cclienti/tig-welder/boards/small-power/small-power.kicad_pcb

## KiCad design boards/small-power/small-power.kicad_pcb (2023-11-25)

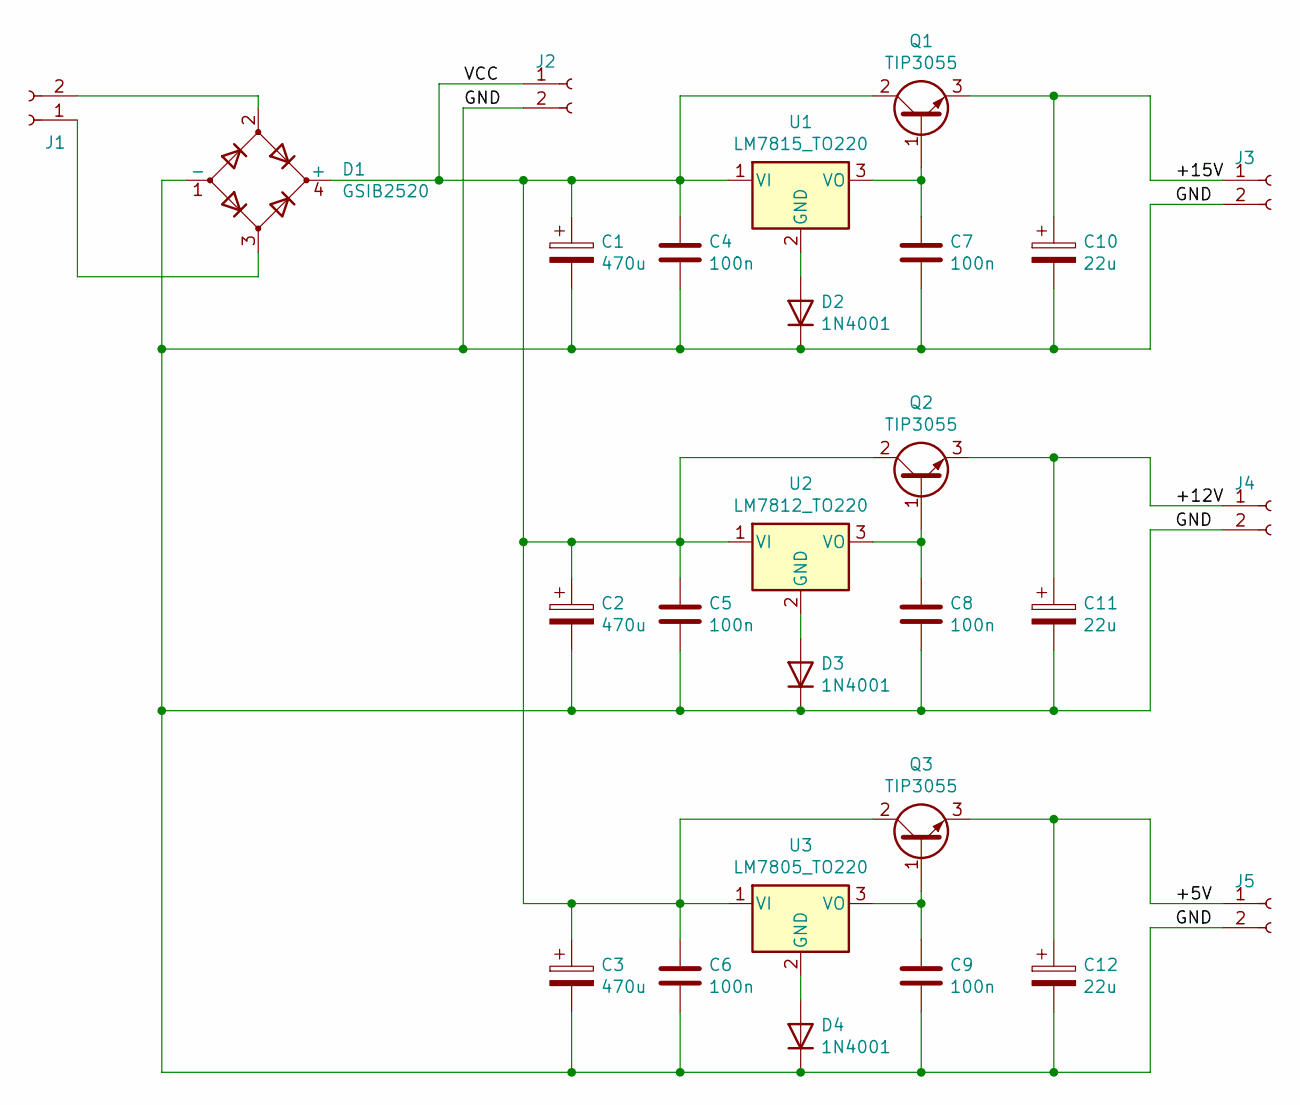
[picture p1: schematic small-power.kicad_sch, Small Power Board]

Parts:
C1, C2, C3: 470u; CP_Radial_D13.0mm_P5.00mm
C4, C5, C6, C7, C8, C9: 100n; C_Rect_L4.6mm_W2.0mm_P2.50mm_MKS02_FKP02
C10, C11, C12: 22u; CP_Radial_D5.0mm_P2.50mm
D1: GSIB2520; Diode_Bridge_32.0x5.6x17.0mm_P10.0mm_P7.5mm
D2, D3, D4: 1N4001; D_DO-41_SOD81_P10.16mm_Horizontal
J1, J2, J3, J4, J5: Conn_01x02_Female; PhoenixContact_MSTBVA_2,5_2-G-5,08_1x02_P5.08mm_Vertical
Q1, Q2, Q3: TIP3055; TO-218-3_Vertical
U1: LM7815_TO220; TO-220-3_Vertical
U2: LM7812_TO220; TO-220-3_Vertical
U3: LM7805_TO220; TO-220-3_Vertical

Connections:
/+5V: C12.1, J5.1, Q3.3 (E)
/+12V: C11.1, J4.1, Q2.3 (E)
/+15V: C10.1, J3.1, Q1.3 (E)
/GND: C1.2, C2.2, C3.2, C4.2, C5.2, C6.2, C7.2, C8.2, C9.2, C10.2, C11.2, C12.2, D1.1 (-), D2.1 (K), D3.1 (K), D4.1 (K), J2.2, J3.2, J4.2, J5.2
/VCC: C1.1, C2.1, C3.1, C4.1, C5.1, C6.1, D1.4 (+), J2.1, Q1.2 (C), Q2.2 (C), Q3.2 (C), U1.1 (VI), U2.1 (VI), U3.1 (VI)
unnamed: C7.1, Q1.1 (B), U1.3 (VO)
unnamed: C8.1, Q2.1 (B), U2.3 (VO)
unnamed: C9.1, Q3.1 (B), U3.3 (VO)
unnamed: D1.2, J1.2
unnamed: D1.3, J1.1
unnamed: D2.2 (A), U1.2 (GND)
unnamed: D3.2 (A), U2.2 (GND)
unnamed: D4.2 (A), U3.2 (GND)

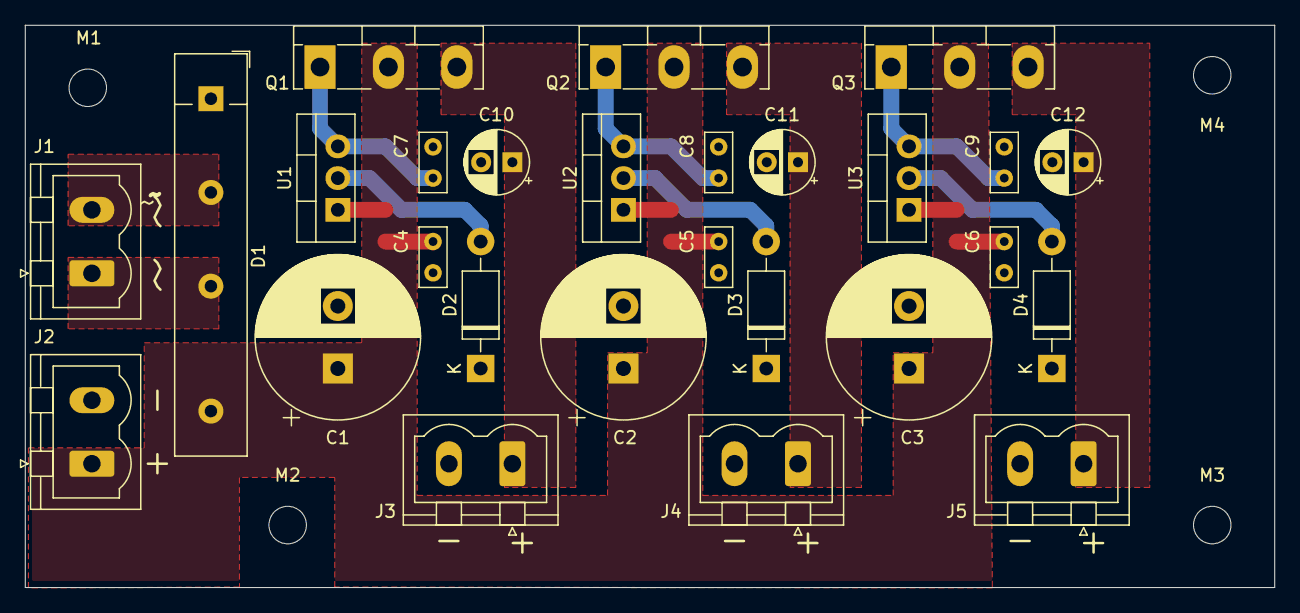
[picture p2: board small-power.kicad_pcb from above]

Board: 2 copper layers, 100.0 x 45.0 mm, 31 parts (0 on the bottom side), 13 nets.

Other parts of the board:
M1, M2, M3, M4: MountingHole_3mm
