cclienti/tig-welder/boards/slow-switching-outputs/slow-switching-outputs.kicad_pcb

## KiCad design boards/slow-switching-outputs/slow-switching-outputs.kicad_pcb (2023-11-25)

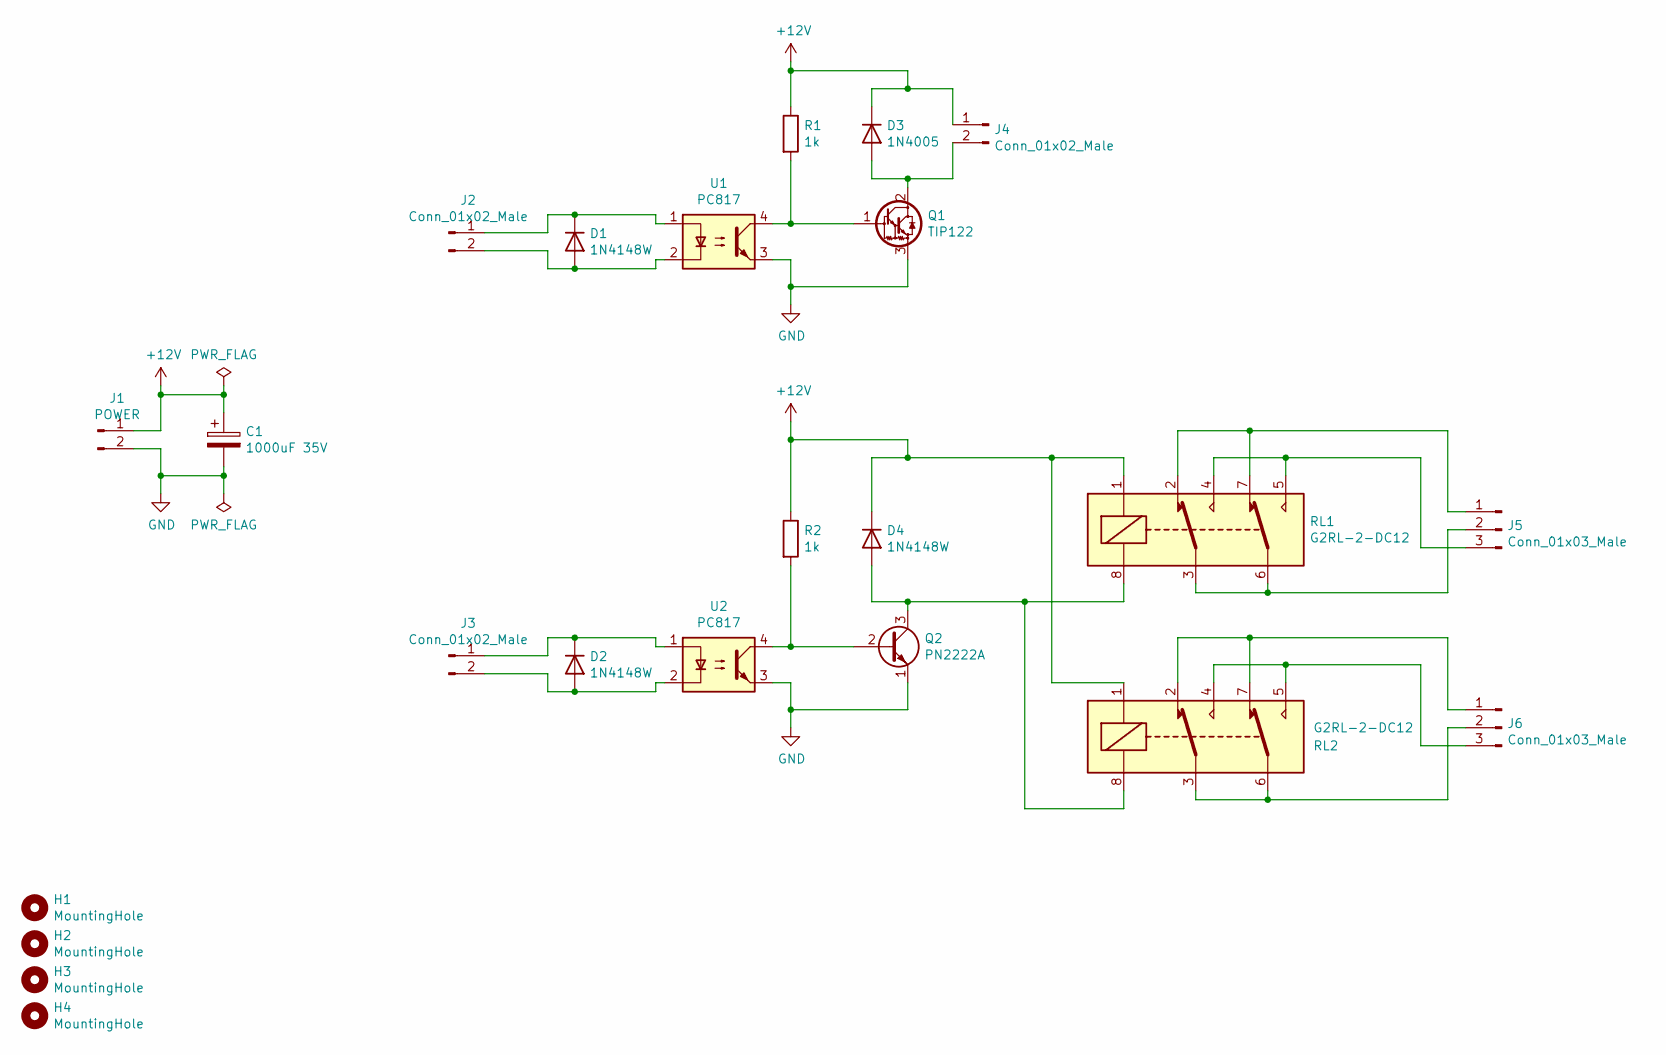
[picture p3: schematic slow-switching-outputs.kicad_sch, Slow Switching Outputs]

Parts:
C1: 1000uF 35V; CP_Radial_D16.0mm_P7.50mm
D1, D2, D4: 1N4148W; D_SOD-123
D3: 1N4005; D_SMB_Handsoldering
H1, H2, H3, H4: MountingHole; MountingHole_3.2mm_M3_Pad
J1: POWER; PhoenixContact_MSTBVA_2,5_2-G-5,08_1x02_P5.08mm_Vertical
J2, J3: Conn_01x02_Male; PinHeader_1x02_P2.54mm_Vertical
J4: Conn_01x02_Male; PhoenixContact_MSTBVA_2,5_2-G-5,08_1x02_P5.08mm_Vertical
J5, J6: Conn_01x03_Male; PhoenixContact_MSTBVA_2,5_3-G-5,08_1x03_P5.08mm_Vertical
Q1: TIP122; TO-220-3_Vertical
Q2: PN2222A; TO-18-3
R1, R2: 1k; R_1206_3216Metric_Pad1.30x1.75mm_HandSolder
RL1, RL2: G2RL-2-DC12; Relay_DPDT_Omron_G2RL
U1, U2: PC817; DIP-4_W7.62mm

Connections:
+12V: C1.1, D3.1 (K), D4.1 (K), J1.1, J4.1, R1.1, R2.1, RL1.1, RL2.1
GND: C1.2, J1.2, Q1.3 (E), Q2.1 (E), U1.3, U2.3
unnamed: D1.1 (K), J2.1, U1.1
unnamed: D1.2 (A), J2.2, U1.2
unnamed: D2.1 (K), J3.1, U2.1
unnamed: D2.2 (A), J3.2, U2.2
unnamed: D3.2 (A), J4.2, Q1.2 (C)
unnamed: D4.2 (A), Q2.3 (C), RL1.8, RL2.8
unnamed: J5.1, RL1.2, RL1.7
unnamed: J5.2, RL1.3, RL1.6
unnamed: J5.3, RL1.4, RL1.5
unnamed: J6.1, RL2.2, RL2.7
unnamed: J6.2, RL2.3, RL2.6
unnamed: J6.3, RL2.4, RL2.5
unnamed: Q1.1 (B), R1.2, U1.4
unnamed: Q2.2 (B), R2.2, U2.4

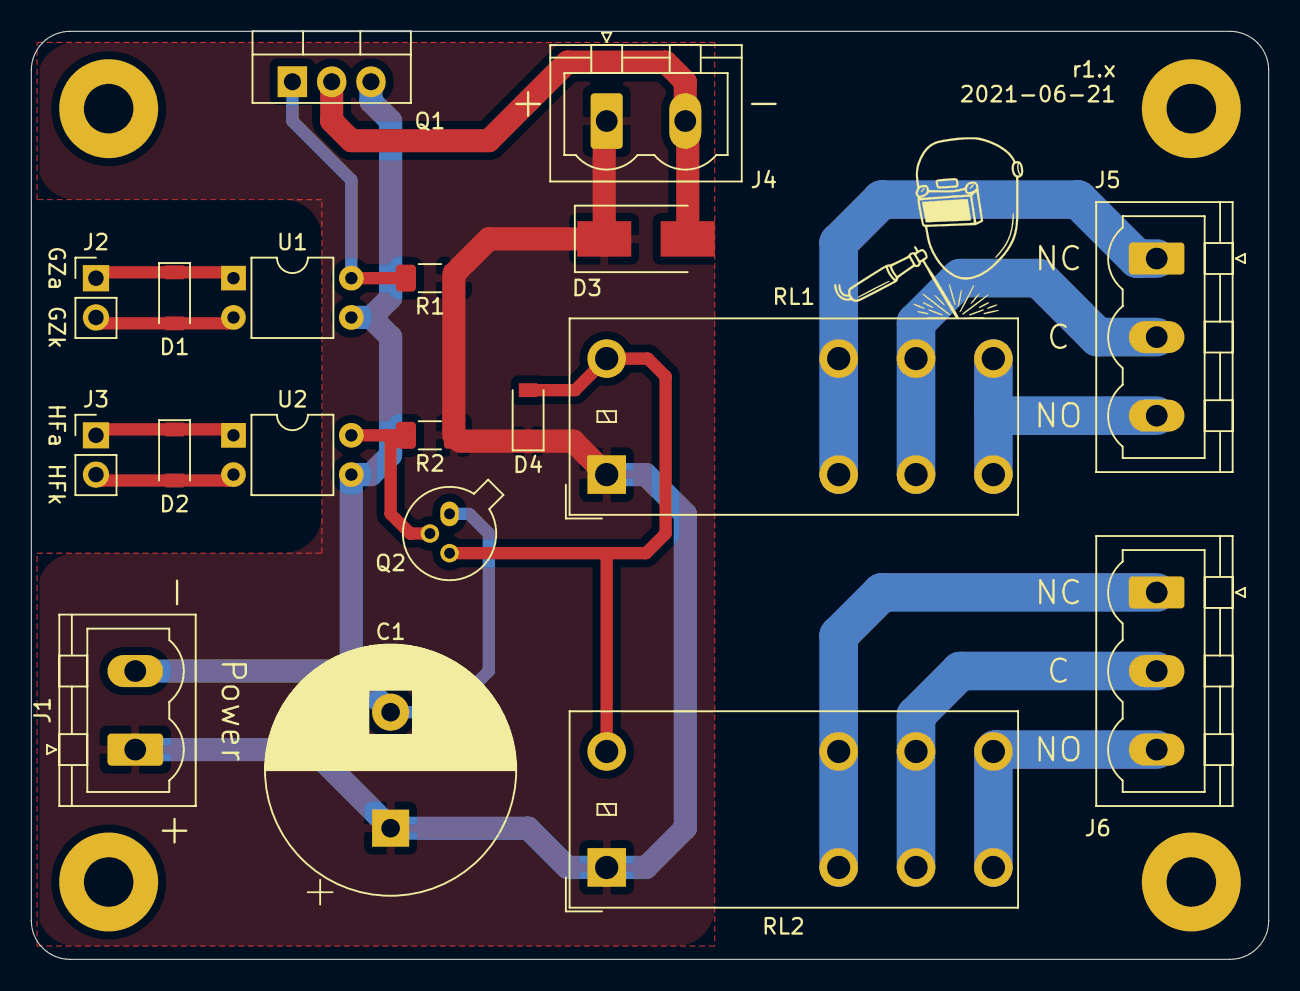
[picture p4: board slow-switching-outputs.kicad_pcb from above]

Board: 2 copper layers, 80.0 x 60.0 mm, 23 parts (0 on the bottom side), 16 nets.
