cclienti/tig-welder/boards/power-driver/power-driver.kicad_pcb

## KiCad design boards/power-driver/power-driver.kicad_pcb (2023-11-25)

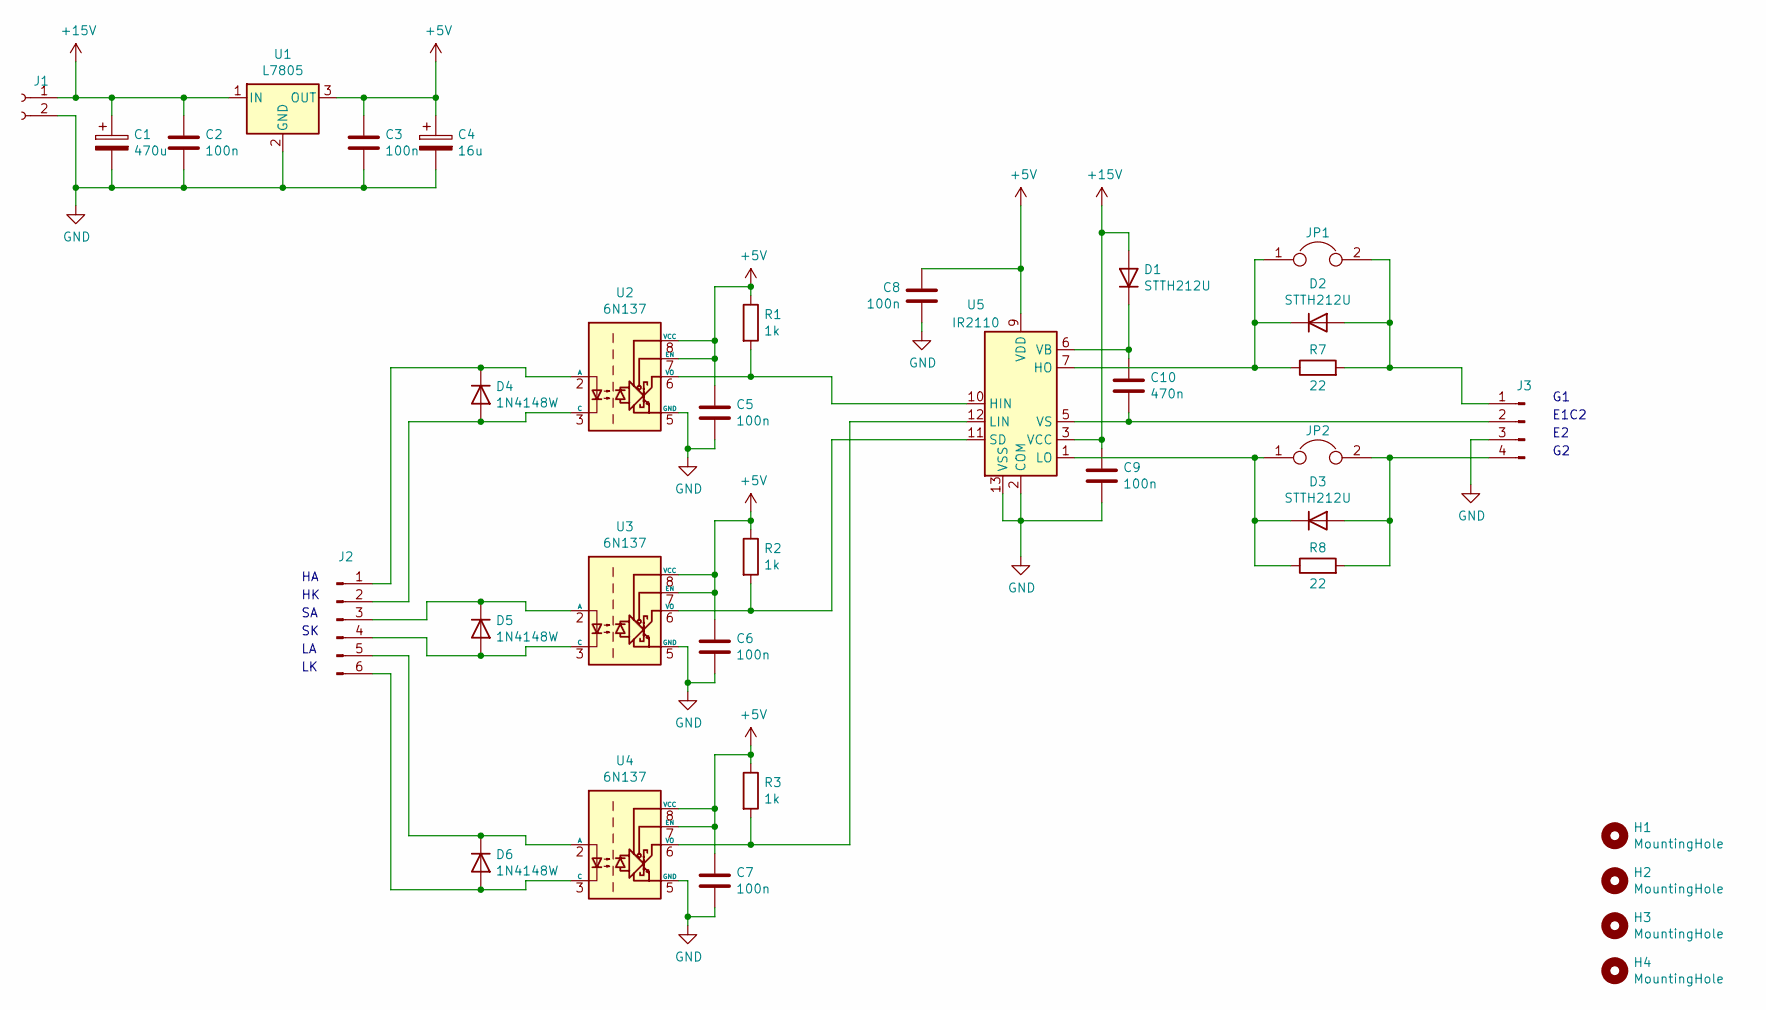
[picture p5: schematic power-driver.kicad_sch, Half Bridge Driver]

Parts:
C1: 470u; CP_Elec_6.3x7.7
C2, C3, C5, C6, C7, C8, C9: 100n; C_1206_3216Metric_Pad1.33x1.80mm_HandSolder
C4: 16u; CP_Elec_5x5.3
C10: 470n; C_Rect_L13.0mm_W6.0mm_P10.00mm_FKS3_FKP3_MKS4
D1, D2, D3: STTH212U; D_SMB
D4, D5, D6: 1N4148W; D_SOD-123
H1, H2, H3, H4: MountingHole; MountingHole_3.2mm_M3_Pad
J1: Conn_01x02_Female; PhoenixContact_MSTBVA_2,5_2-G-5,08_1x02_P5.08mm_Vertical
J2: Conn_01x06_Male; PinHeader_1x06_P2.54mm_Vertical
J3: Conn_01x04_Male; PinHeader_1x04_P2.54mm_Vertical
JP1, JP2: Jumper; PinHeader_1x02_P2.54mm_Vertical
R1, R2, R3: 1k; R_1206_3216Metric_Pad1.30x1.75mm_HandSolder
R7, R8: 22; R_1206_3216Metric_Pad1.30x1.75mm_HandSolder
U1: L7805; TO-220-3_Horizontal_TabDown
U2, U3, U4: 6N137; DIP-8_W7.62mm
U5: IR2110; DIP-14_W7.62mm

Connections:
+5V: C3.1, C4.1, C5.1, C6.1, C7.1, C8.2, R1.1, R2.1, R3.1, U1.3 (OUT), U2.7 (EN), U2.8 (VCC), U3.7 (EN), U3.8 (VCC), U4.7 (EN), U4.8 (VCC), U5.9 (VDD)
+15V: C1.1, C2.1, C9.1, D1.2 (A), J1.1, U1.1 (IN), U5.3 (VCC)
GND: C1.2, C2.2, C3.2, C4.2, C5.2, C6.2, C7.2, C8.1, C9.2, J1.2, J3.3, U1.2 (GND), U2.5 (GND), U3.5 (GND), U4.5 (GND), U5.2 (COM), U5.13 (VSS)
unnamed: C10.1, D1.1 (K), U5.6 (VB)
unnamed: C10.2, J3.2, U5.5 (VS)
unnamed: D2.1 (K), JP1.1, R7.1, U5.7 (HO)
unnamed: D2.2 (A), J3.1, JP1.2, R7.2
unnamed: D3.1 (K), JP2.1, R8.1, U5.1 (LO)
unnamed: D3.2 (A), J3.4, JP2.2, R8.2
unnamed: D4.1 (K), J2.1, U2.2 (A)
unnamed: D4.2 (A), J2.2, U2.3 (C)
unnamed: D5.1 (K), J2.3, U3.2 (A)
unnamed: D5.2 (A), J2.4, U3.3 (C)
unnamed: D6.1 (K), J2.5, U4.2 (A)
unnamed: D6.2 (A), J2.6, U4.3 (C)
unnamed: R1.2, U2.6 (VO), U5.10 (HIN)
unnamed: R2.2, U3.6 (VO), U5.11 (SD)
unnamed: R3.2, U4.6 (VO), U5.12 (LIN)

Notes on the sheet:
E1C2

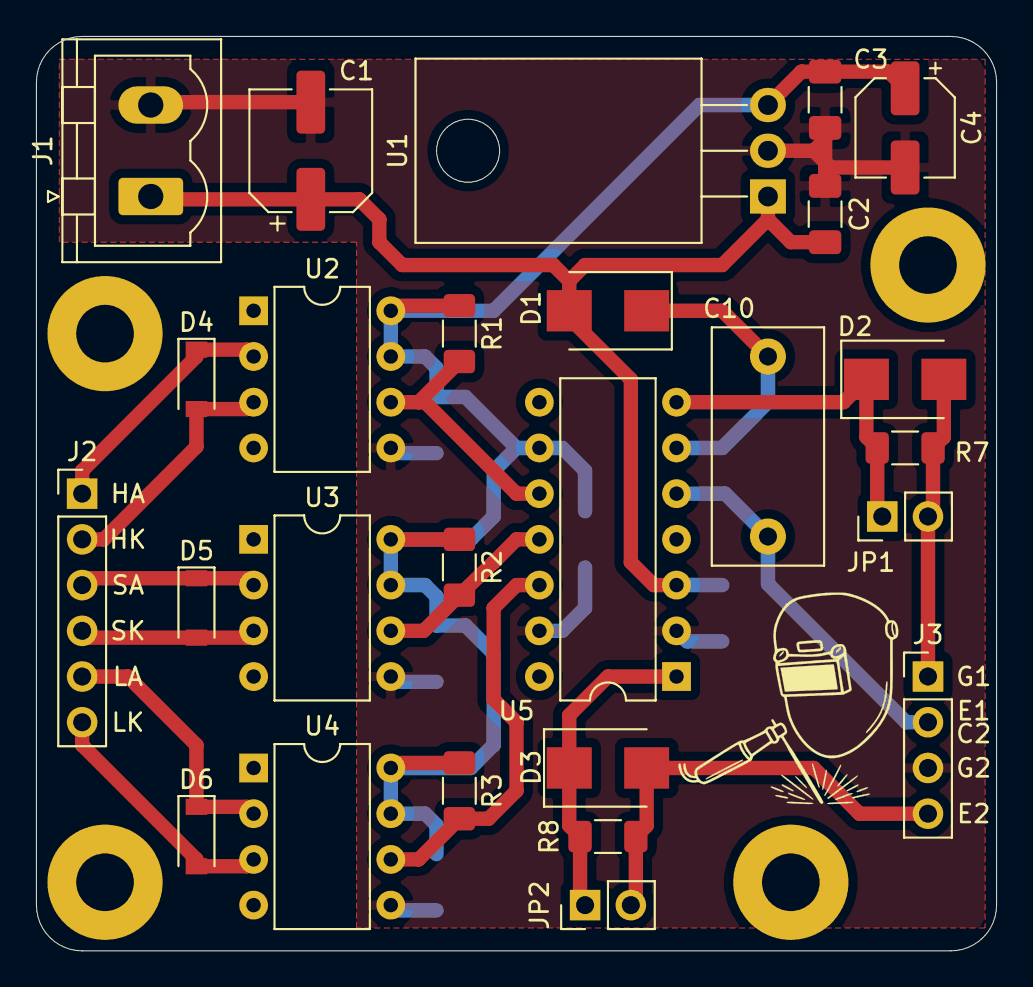
[picture p6: board power-driver.kicad_pcb from above]

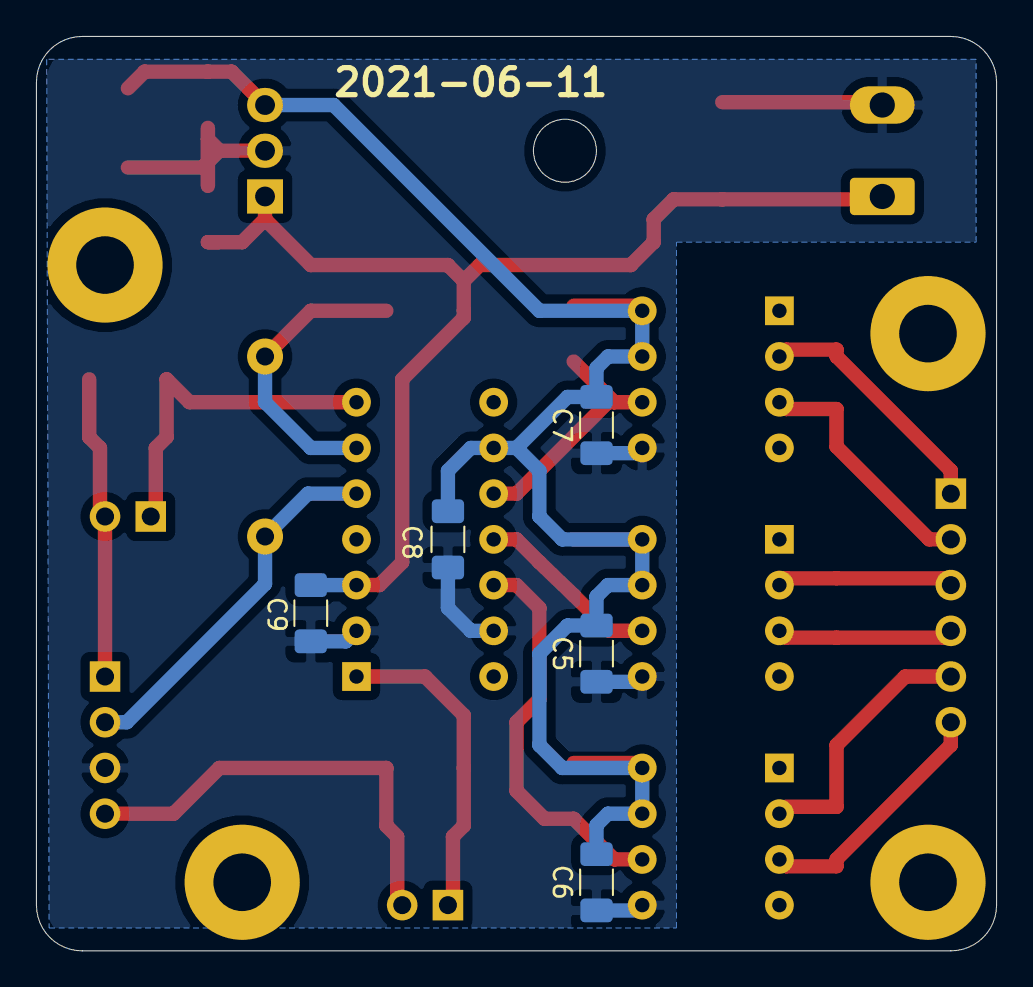
[picture p7: board power-driver.kicad_pcb from below]

Board: 2 copper layers, 53.3 x 50.8 mm, 35 parts (5 on the bottom side), 18 nets.
