cclienti/tig-welder/boards/half-bridge-mod/half-bridge-mod.kicad_pcb

## KiCad design boards/half-bridge-mod/half-bridge-mod.kicad_pcb (2023-11-25)

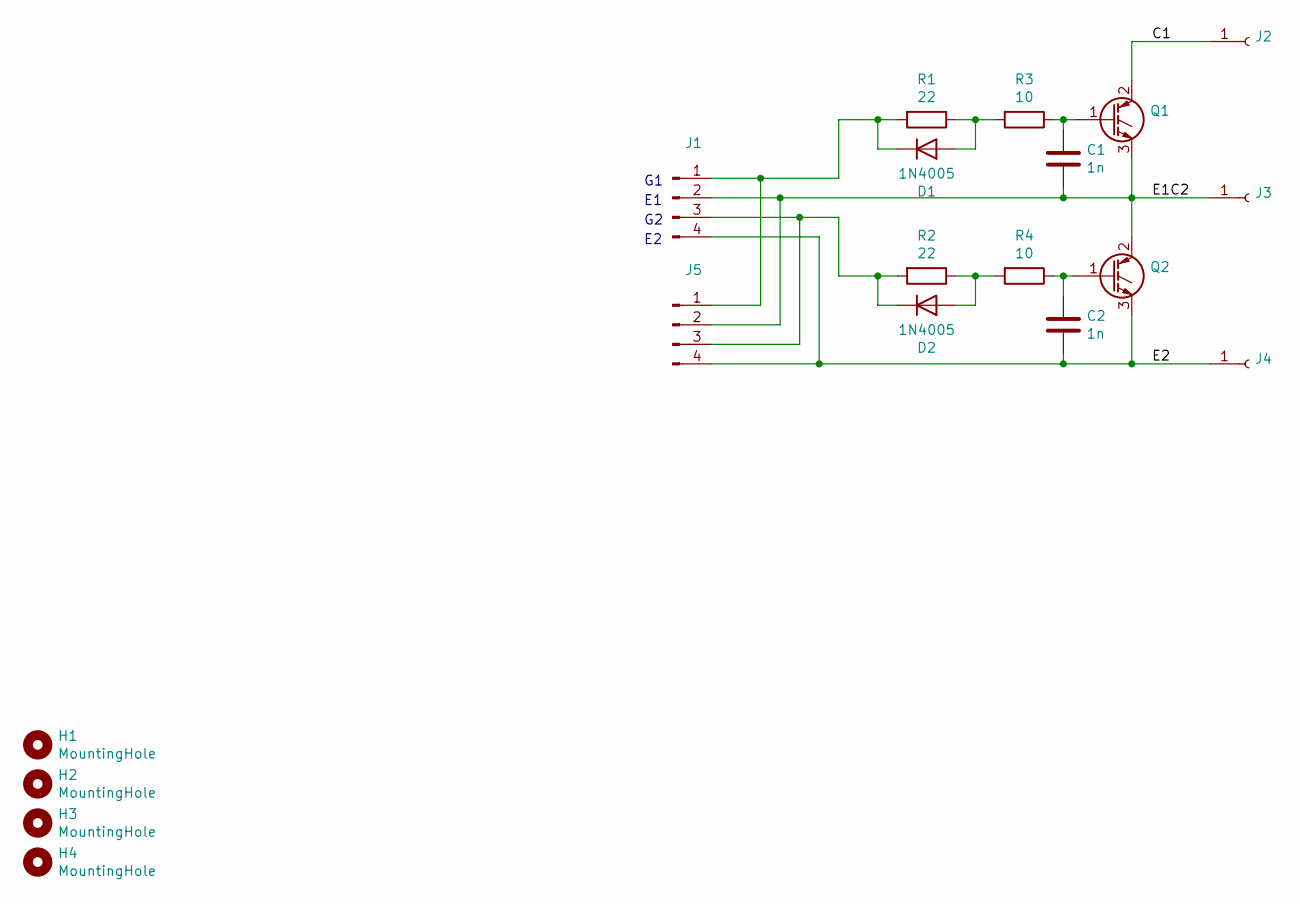
[picture p8: schematic half-bridge-mod.kicad_sch, Modular Half-Bridge]

Parts:
C1, C2: 1n; C_1206_3216Metric
D1, D2: 1N4005; D_SMA
H1, H2, H3, H4: MountingHole; MountingHole_2.2mm_M2
J1, J5: Conn_01x04_Male; PinHeader_1x04_P2.54mm_Vertical
J2, J3, J4: Conn_01x01_Female; Terminal_Block_Welder_no_hole
Q1, Q2: Q_NIGBT_GCE; TO-247-3_Horizontal_TabUp
R1, R2: 22; R_1206_3216Metric
R3, R4: 10; R_1206_3216Metric

Connections:
/C1: J2.1, Q1.2 (C)
/E1C2: C1.2, J1.2, J3.1, J5.2, Q1.3 (E), Q2.2 (C)
/E2: C2.2, J1.4, J4.1, J5.4, Q2.3 (E)
unnamed: C1.1, Q1.1 (G), R3.1
unnamed: C2.1, Q2.1 (G), R4.1
unnamed: D1.1 (K), J1.1, J5.1, R1.2
unnamed: D1.2 (A), R1.1, R3.2
unnamed: D2.1 (K), J1.3, J5.3, R2.2
unnamed: D2.2 (A), R2.1, R4.2

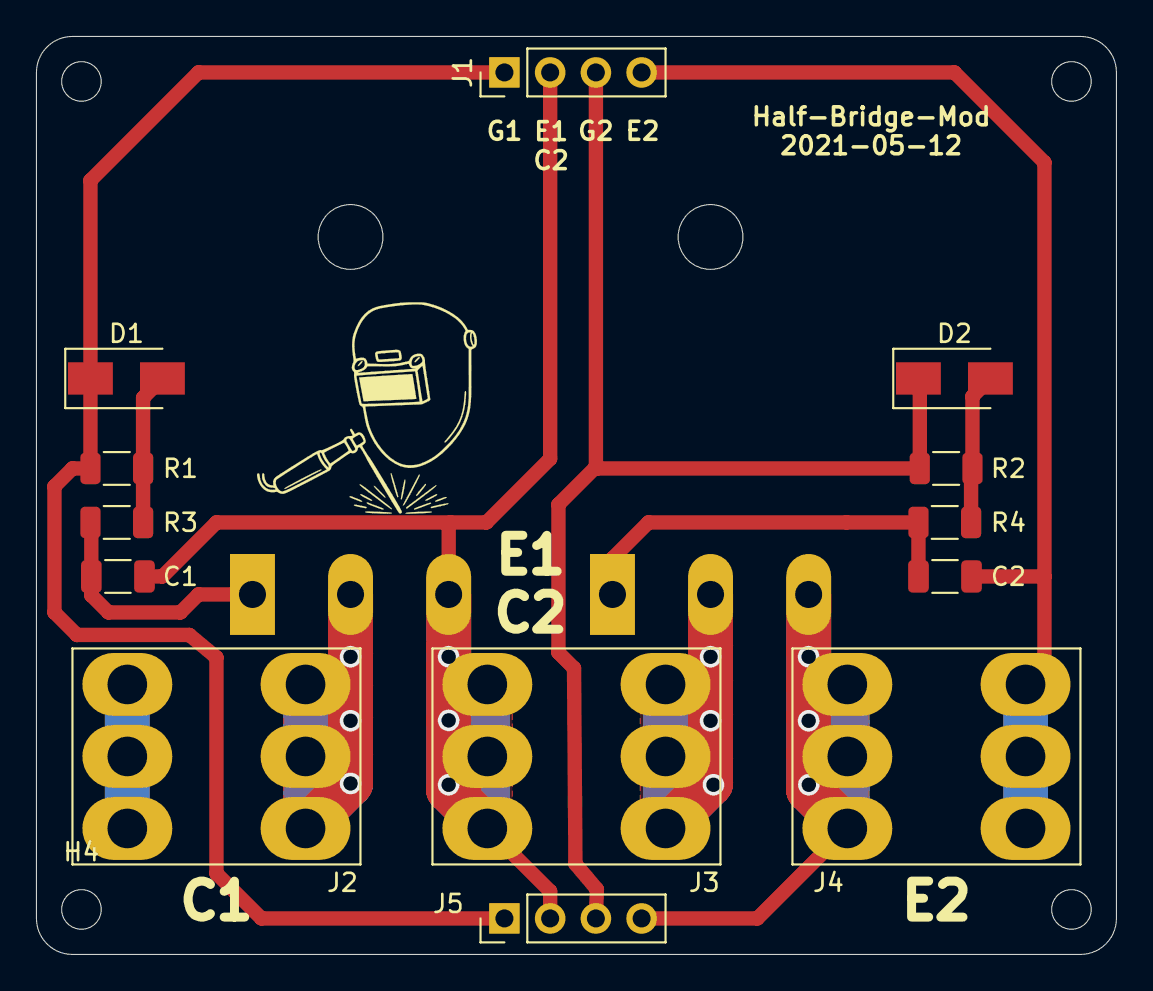
[picture p9: board half-bridge-mod.kicad_pcb from above]

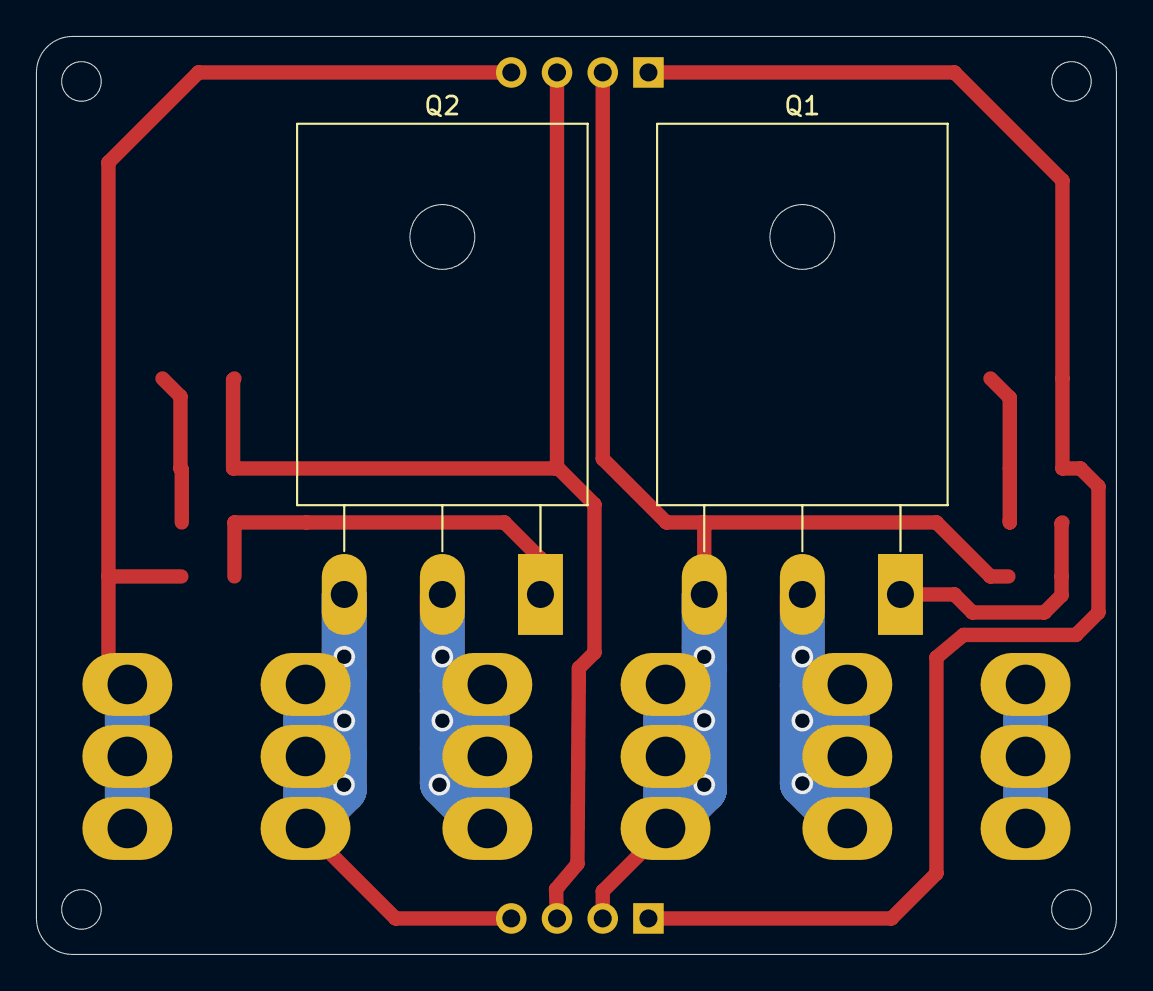
[picture p10: board half-bridge-mod.kicad_pcb from below]

Board: 2 copper layers, 60.0 x 51.0 mm, 19 parts (2 on the bottom side), 9 nets.
