cclienti/tig-welder/boards/dspic-controller/dspic-controller.kicad_pcb

## KiCad design boards/dspic-controller/dspic-controller.kicad_pcb (2023-11-25)

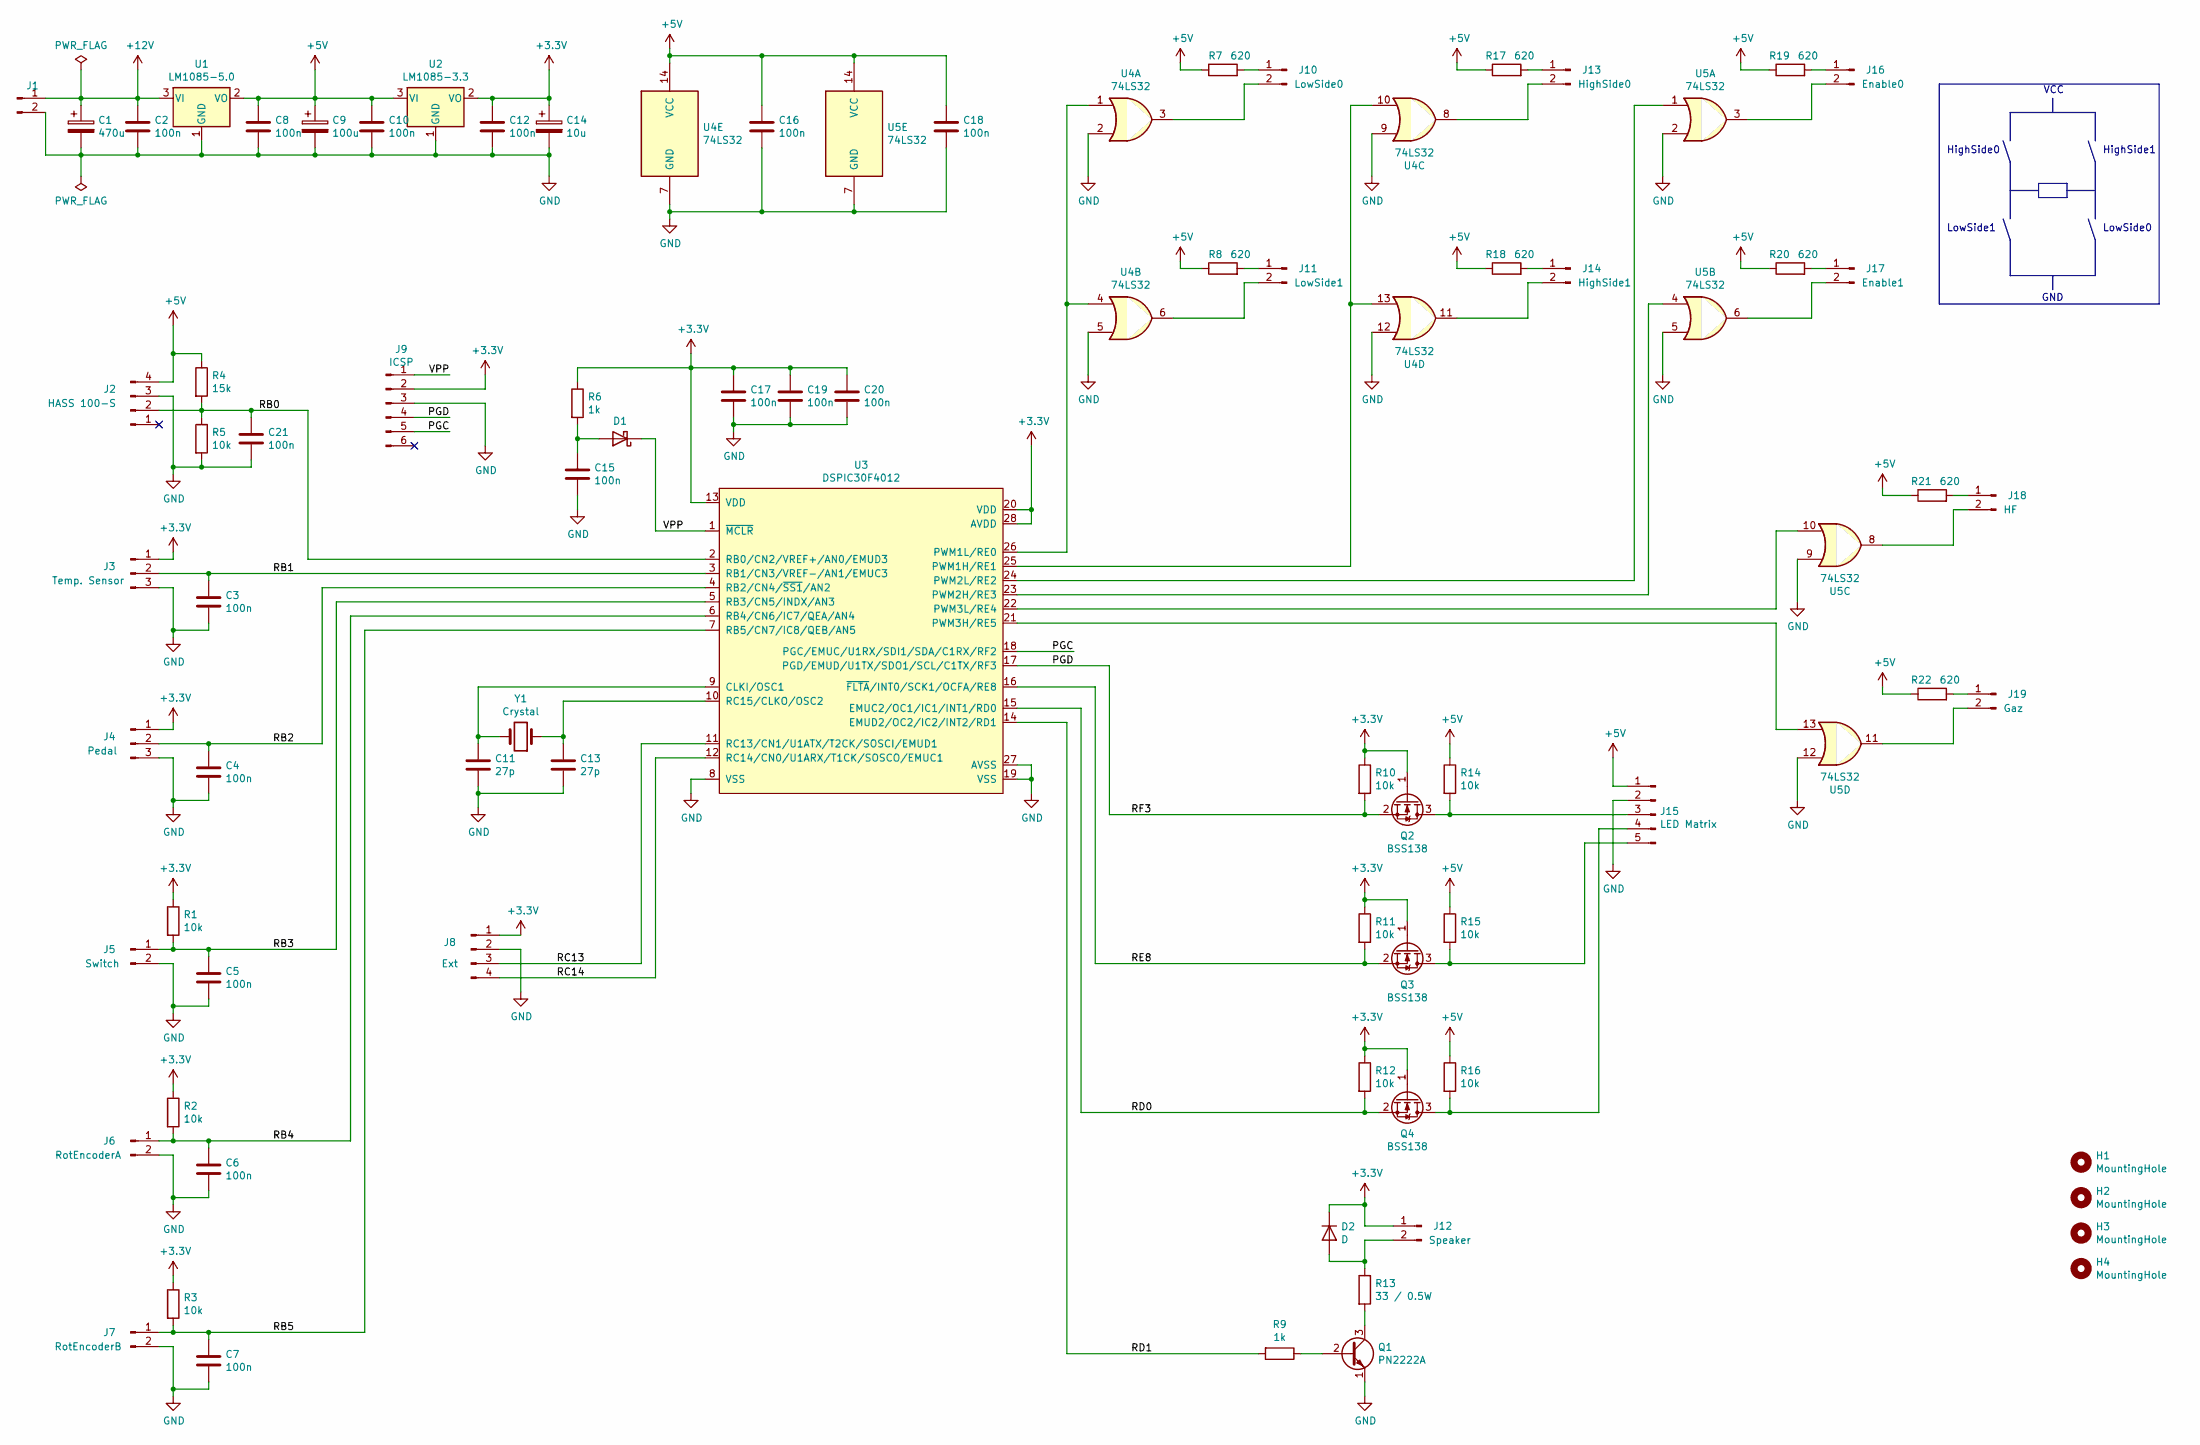
[picture p11: schematic dspic-controller.kicad_sch, TIG Welder dsPIC controller]

Parts:
C1: 470u; CP_Radial_D13.0mm_P5.00mm
C2, C3, C4, C5, C6, C7, C8, C10, C12, C15, C16, C17, C18, C19, C20, C21: 100n; C_1206_3216Metric_Pad1.33x1.80mm_HandSolder
C9: 100u; CP_Elec_6.3x5.4
C11, C13: 27p; C_1206_3216Metric_Pad1.33x1.80mm_HandSolder
C14: 10u; CP_Elec_5x5.3
D1: MBR1020VL; D_1206_3216Metric_Pad1.42x1.75mm_HandSolder
D2: D; D_1206_3216Metric_Pad1.42x1.75mm_HandSolder
H1, H2, H3, H4: MountingHole; MountingHole_3.2mm_M3
J1: Power Input; PhoenixContact_MSTBVA_2,5_2-G-5,08_1x02_P5.08mm_Vertical
J2: HASS 100-S; PinHeader_1x04_P2.54mm_Vertical
J3: Temp. Sensor; PinHeader_1x03_P2.54mm_Vertical
J4: Pedal; PinHeader_1x03_P2.54mm_Vertical
J5: Switch; PinHeader_1x02_P2.54mm_Vertical
J6: RotEncoderA; PinHeader_1x02_P2.54mm_Vertical
J7: RotEncoderB; PinHeader_1x02_P2.54mm_Vertical
J8: Ext; PinHeader_1x04_P2.54mm_Vertical
J9: ICSP; PinHeader_1x06_P2.54mm_Vertical
J10: LowSide0; PinHeader_1x02_P2.54mm_Vertical
J11: LowSide1; PinHeader_1x02_P2.54mm_Vertical
J12: Speaker; PinHeader_1x02_P2.54mm_Vertical
J13: HighSide0; PinHeader_1x02_P2.54mm_Vertical
J14: HighSide1; PinHeader_1x02_P2.54mm_Vertical
J15: LED Matrix; PinHeader_1x05_P2.54mm_Vertical
J16: Enable0; PinHeader_1x02_P2.54mm_Vertical
J17: Enable1; PinHeader_1x02_P2.54mm_Vertical
J18: HF; PinHeader_1x02_P2.54mm_Vertical
J19: Gaz; PinHeader_1x02_P2.54mm_Vertical
Q1: PN2222A; TO-18-3
Q2, Q3, Q4: BSS138; SOT-23_Handsoldering
R1, R2, R3, R5, R10, R11, R12, R14, R15, R16: 10k; R_1206_3216Metric_Pad1.30x1.75mm_HandSolder
R4: 15k; R_1206_3216Metric_Pad1.30x1.75mm_HandSolder
R6, R9: 1k; R_1206_3216Metric_Pad1.30x1.75mm_HandSolder
R7, R8, R17, R18, R19, R20, R21, R22: 620; R_1206_3216Metric_Pad1.30x1.75mm_HandSolder
R13: 33 / 0.5W; R_Axial_DIN0207_L6.3mm_D2.5mm_P7.62mm_Horizontal
U1: LM1085-5.0; TO-220-3_Vertical
U2: LM1085-3.3; TO-220-3_Vertical
U3: DSPIC30F4012; DIP-28_W7.62mm
U4, U5: 74LS32; DIP-14_W7.62mm
Y1: Crystal; Crystal_SMD_HC49-SD

Connections:
+3V3: C12.1, C14.1, C17.1, C19.1, C20.1, D2.1 (K), J3.1, J4.1, J8.1, J9.2, J12.1, Q2.1 (G), Q3.1 (G), Q4.1 (G), R1.1, R2.1, R3.1, R6.1, R10.1, R11.1, R12.1, U2.2 (VO), U3.13 (VDD), U3.20 (VDD), U3.28 (AVDD)
+5V: C8.1, C9.1, C10.1, C16.1, C18.1, J2.4, J15.1, R4.1, R7.1, R8.1, R14.1, R15.1, R16.1, R17.1, R18.1, R19.1, R20.1, R21.1, R22.1, U1.2 (VO), U2.3 (VI), U4.14 (VCC), U5.14 (VCC)
+12V: C1.1, C2.1, J1.1, U1.3 (VI)
/PGC: J9.5, U3.18 (PGC/EMUC/U1RX/SDI1/SDA/C1RX/RF2)
/PGD: J9.4, Q2.2 (S), R10.2, U3.17 (PGD/EMUD/U1TX/SDO1/SCL/C1TX/RF3)
/RB0: C21.1, J2.2, R4.2, R5.1, U3.2 (RB0/CN2/VREF+/AN0/EMUD3)
/RB1: C3.1, J3.2, U3.3 (RB1/CN3/VREF-/AN1/EMUC3)
/RB2: C4.1, J4.2, U3.4 (RB2/CN4/~SS1/AN2)
/RB3: C5.1, J5.1, R1.2, U3.5 (RB3/CN5/INDX/AN3)
/RB4: C6.1, J6.1, R2.2, U3.6 (RB4/CN6/IC7/QEA/AN4)
/RB5: C7.1, J7.1, R3.2, U3.7 (RB5/CN7/IC8/QEB/AN5)
/RC13: J8.3, U3.11 (RC13/CN1/U1ATX/T2CK/SOSCI/EMUD1)
/RC14: J8.4, U3.12 (RC14/CN0/U1ARX/T1CK/SOSCO/EMUC1)
/RD0: Q4.2 (S), R12.2, U3.15 (EMUC2/OC1/IC1/INT1/RD0)
/RD1: R9.2, U3.14 (EMUD2/OC2/IC2/INT2/RD1)
/RE8: Q3.2 (S), R11.2, U3.16 (~FLTA/INT0/SCK1/OCFA/RE8)
/VPP: D1.1 (K), J9.1, U3.1 (~MCLR)
GND: C1.2, C2.2, C3.2, C4.2, C5.2, C6.2, C7.2, C8.2, C9.2, C10.2, C11.2, C12.2, C13.2, C14.2, C15.2, C16.2, C17.2, C18.2, C19.2, C20.2, C21.2, J1.2, J2.3, J3.3, J4.3, J5.2, J6.2, J7.2, J8.2, J9.3, J15.2, Q1.1 (E), R5.2, U1.1 (GND), U2.1 (GND), U3.8 (VSS), U3.19 (VSS), U3.27 (AVSS), U4.2, U4.5, U4.7 (GND), U4.9, U4.12, U5.2, U5.5, U5.7 (GND), U5.9, U5.12
unnamed: C11.1, U3.9 (CLKI/OSC1), Y1.2
unnamed: C13.1, U3.10 (RC15/CLKO/OSC2), Y1.1
unnamed: C15.1, D1.2 (A), R6.2
unnamed: D2.2 (A), J12.2, R13.1
unnamed: J10.1, R7.2
unnamed: J10.2, U4.3
unnamed: J11.1, R8.2
unnamed: J11.2, U4.6
unnamed: J13.1, R17.2
unnamed: J13.2, U4.8
unnamed: J14.1, R18.2
unnamed: J14.2, U4.11
unnamed: J15.3, Q2.3 (D), R14.2
unnamed: J15.4, Q4.3 (D), R16.2
unnamed: J15.5, Q3.3 (D), R15.2
unnamed: J16.1, R19.2
unnamed: J16.2, U5.3
unnamed: J17.1, R20.2
unnamed: J17.2, U5.6
unnamed: J18.1, R21.2
unnamed: J18.2, U5.8
unnamed: J19.1, R22.2
unnamed: J19.2, U5.11
unnamed: Q1.2 (B), R9.1
unnamed: Q1.3 (C), R13.2
unnamed: U3.21 (PWM3H/RE5), U5.13
unnamed: U3.22 (PWM3L/RE4), U5.10
unnamed: U3.23 (PWM2H/RE3), U5.4
unnamed: U3.24 (PWM2L/RE2), U5.1
unnamed: U3.25 (PWM1H/RE1), U4.10, U4.13
unnamed: U3.26 (PWM1L/RE0), U4.1, U4.4

Notes on the sheet:
HighSide0
LowSide0
LowSide1
HighSide1
VCC
GND
