cclienti/tig-welder/boards/dspic-controller/dspic-controller.kicad_pcb

## KiCad design boards/dspic-controller/dspic-controller.kicad_pcb (continued)

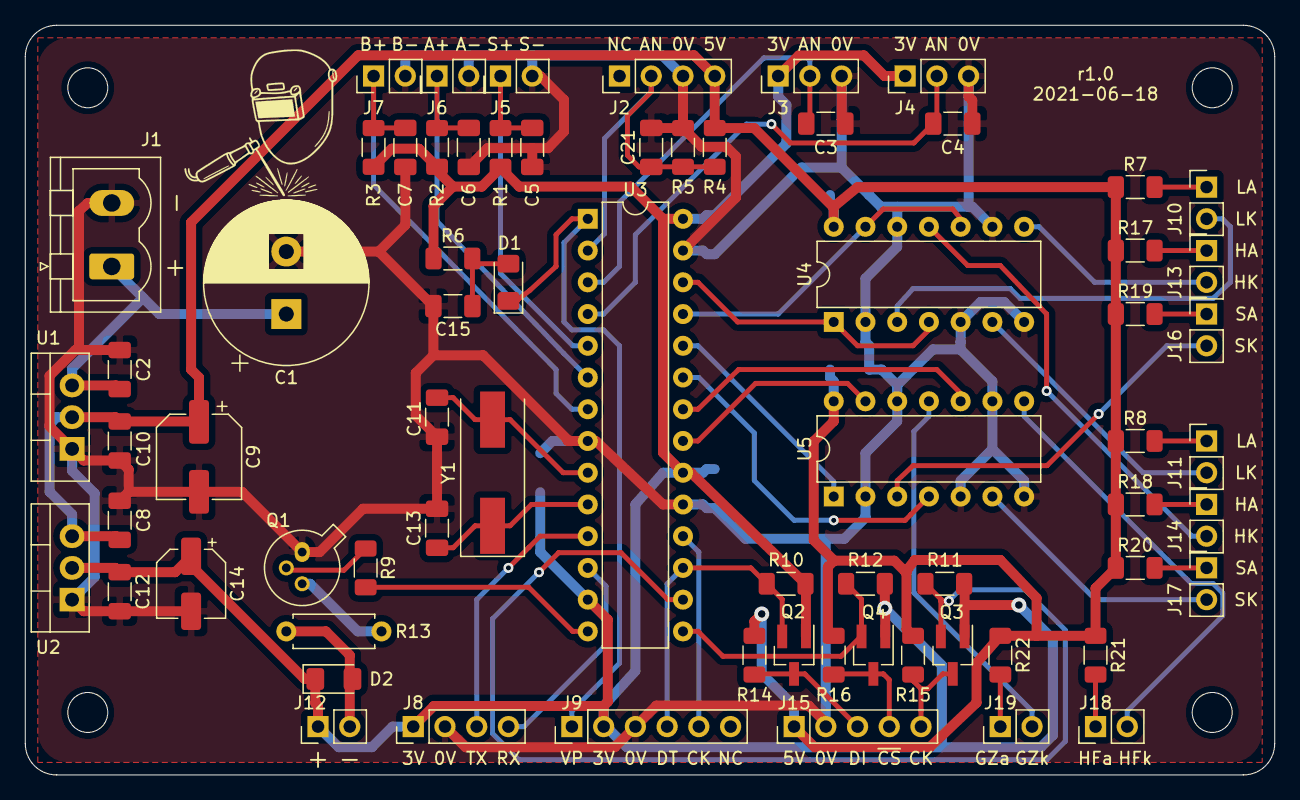
[picture p12: board dspic-controller.kicad_pcb from above]

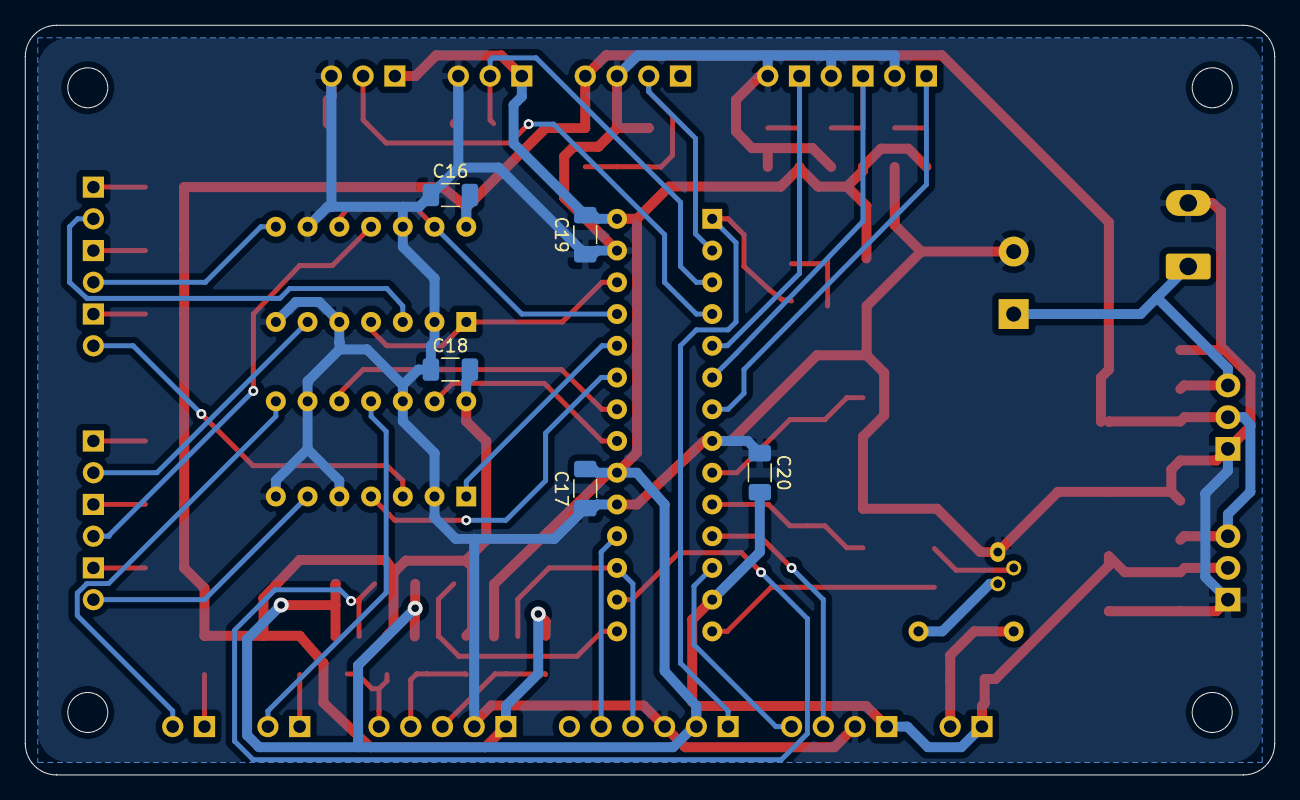
[picture p13: board dspic-controller.kicad_pcb from below]

Board: 2 copper layers, 100.0 x 60.0 mm, 78 parts (5 on the bottom side), 49 nets.
