cclienti/tig-welder/boards/pico-controller/pico-controller.kicad_pcb

## KiCad design boards/pico-controller/pico-controller.kicad_pcb (2023-11-25)

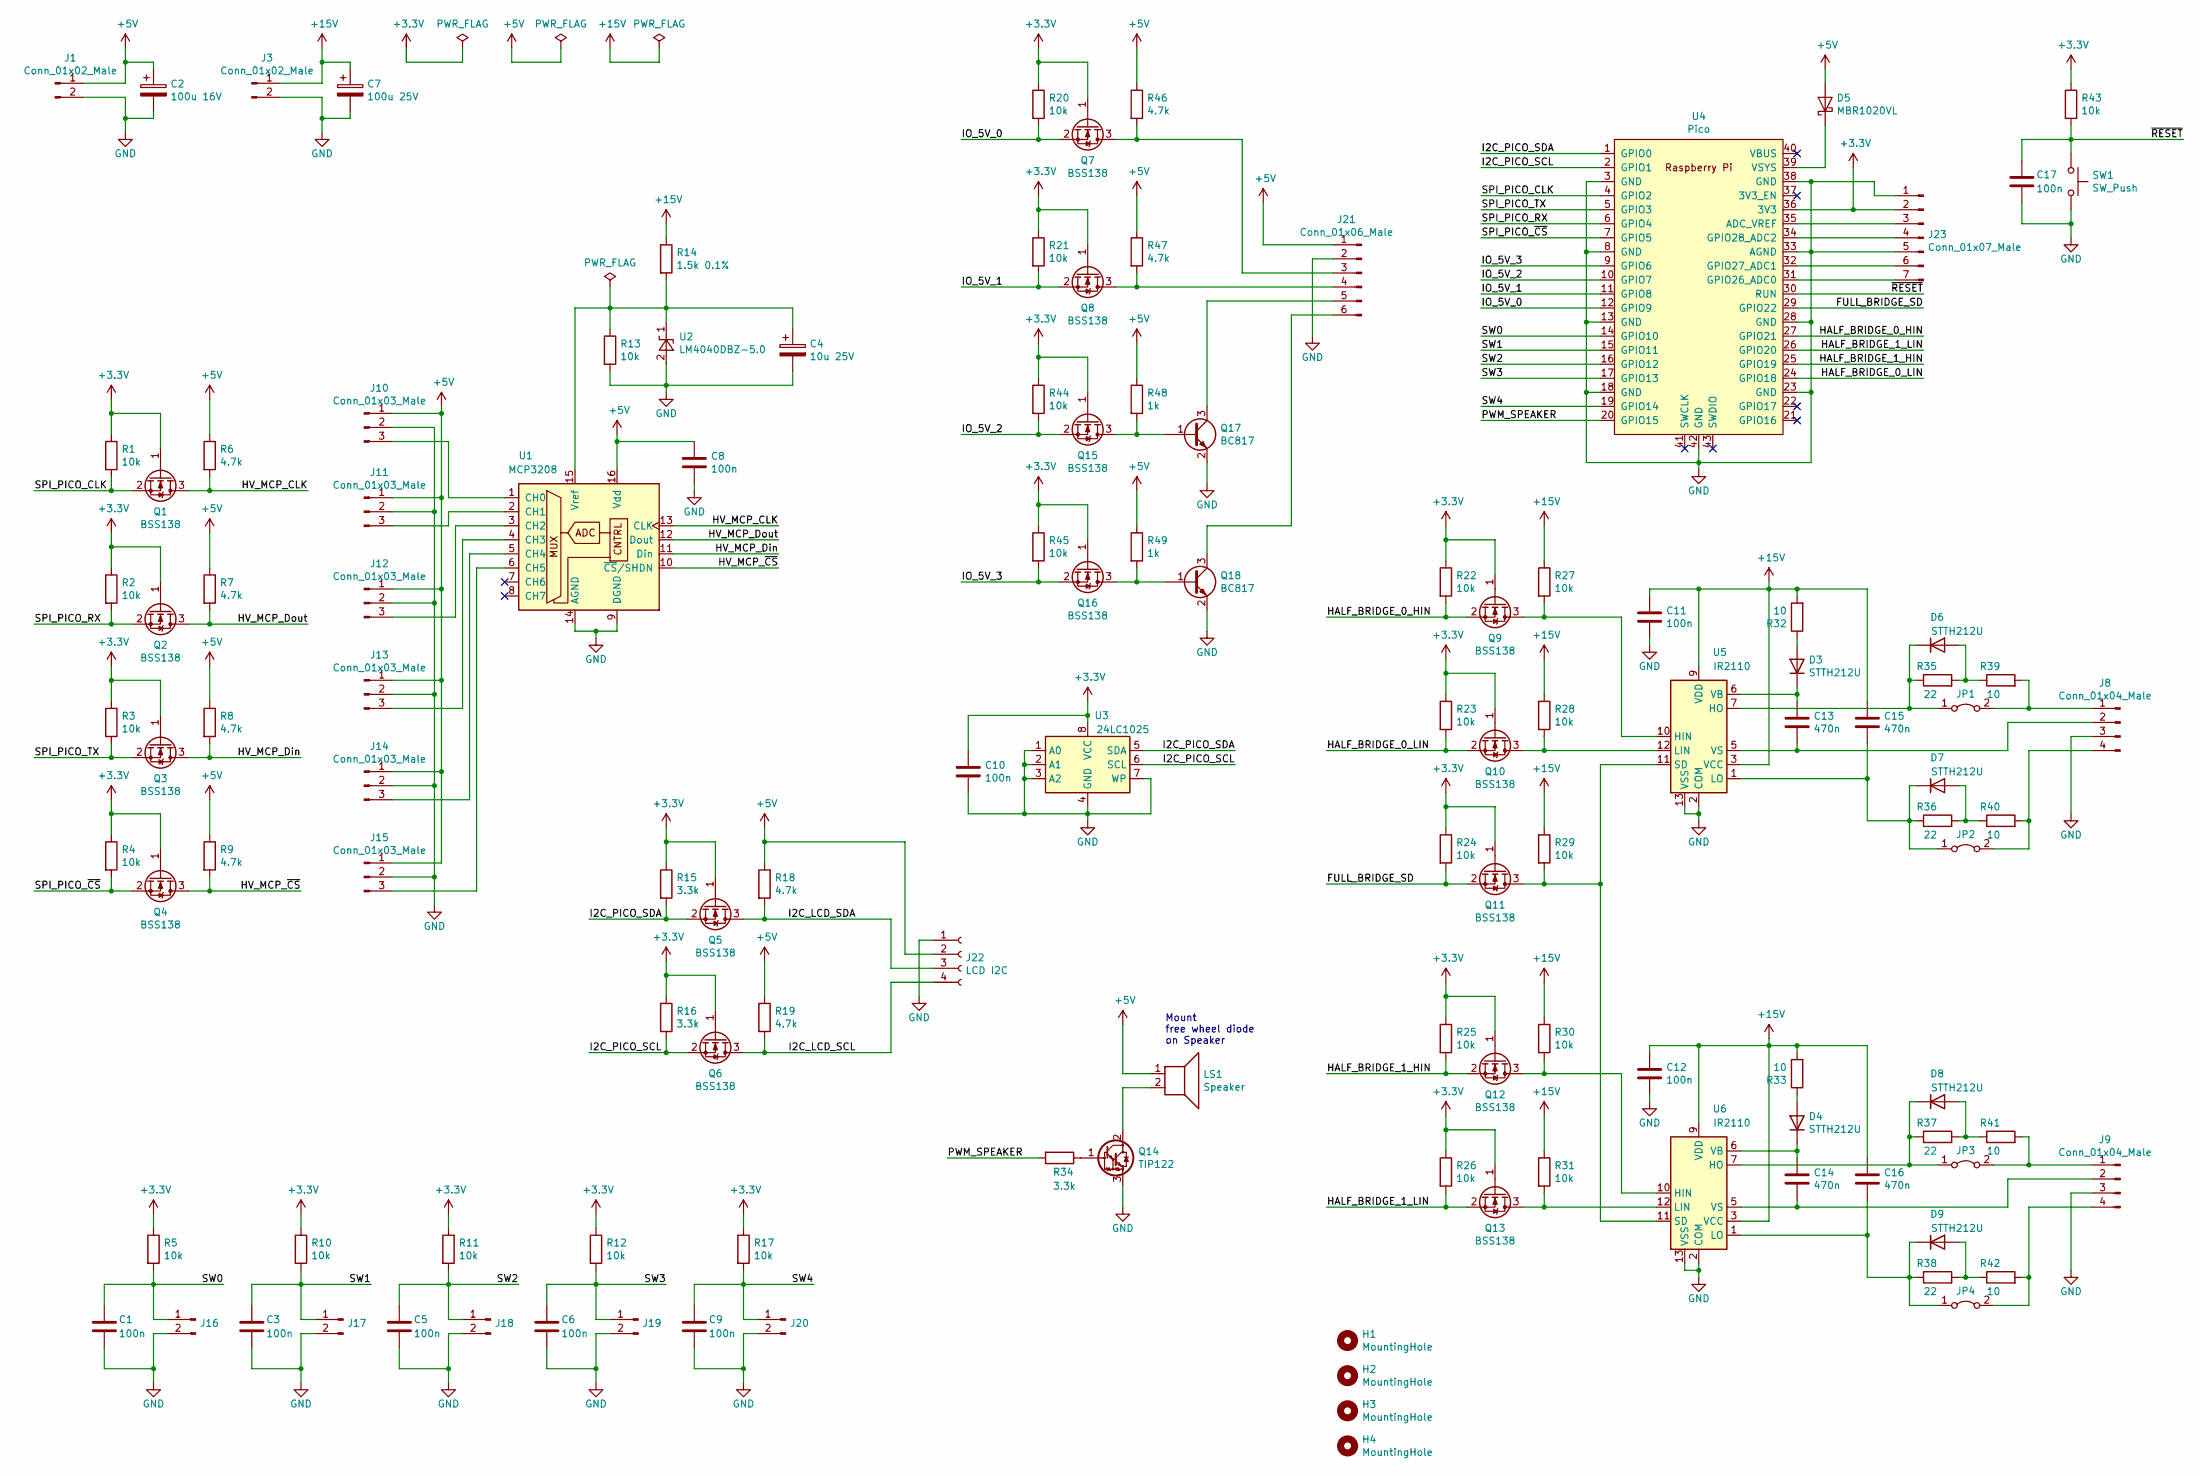
[picture p14: schematic pico-controller.kicad_sch, TIG Welder Pico Controler]

Parts:
C1, C3, C5, C6, C8, C9, C10, C11, C12, C17: 100n; C_1206_3216Metric_Pad1.33x1.80mm_HandSolder
C2: 100u 16V; CP_Elec_6.3x5.4
C4: 10u 25V; CP_Elec_5x5.3
C7: 100u 25V; CP_Elec_6.3x7.7
C13, C14, C15, C16: 470n; C_Rect_L13.0mm_W6.0mm_P10.00mm_FKS3_FKP3_MKS4
D3, D4, D6, D7, D8, D9: STTH212U; D_SMB
D5: MBR1020VL; D_SMA
H1, H2, H3, H4: MountingHole; MountingHole_3mm
J1, J3: Conn_01x02_Male; PhoenixContact_MSTBVA_2,5_2-G-5,08_1x02_P5.08mm_Vertical
J8, J9: Conn_01x04_Male; PinHeader_1x04_P2.54mm_Vertical
J10, J11, J12, J13, J14, J15: Conn_01x03_Male; PinHeader_1x03_P2.54mm_Vertical
J16, J17, J18, J19, J20: Conn_01x02_Male; PinHeader_1x02_P2.54mm_Vertical
J21: Conn_01x06_Male; PinHeader_1x06_P2.54mm_Vertical
J22: LCD I2C; PinHeader_1x04_P2.54mm_Vertical
J23: Conn_01x07_Male; PinHeader_1x07_P2.54mm_Vertical
JP1, JP2, JP3, JP4: Jumper_2_Bridged; PinHeader_1x02_P2.54mm_Vertical
LS1: Speaker; PinHeader_1x02_P2.54mm_Vertical
Q1, Q2, Q3, Q4, Q5, Q6, Q7, Q8, Q9, Q10, Q11, Q12, Q13, Q15, Q16: BSS138; SOT-23_Handsoldering
Q14: TIP122; TO-220-3_Horizontal_TabDown
Q17, Q18: BC817; SOT-23
R1, R2, R3, R4, R5, R10, R11, R12, R13, R17, R20, R21, R22, R23, R24, R25, R26, R27, R28, R29, R30, R31, R43, R44, R45: 10k; R_1206_3216Metric_Pad1.30x1.75mm_HandSolder
R6, R7, R8, R9, R18, R19, R46, R47: 4.7k; R_1206_3216Metric_Pad1.30x1.75mm_HandSolder
R14: 1.5k 0.1%; R_1206_3216Metric_Pad1.30x1.75mm_HandSolder
R15, R16, R34: 3.3k; R_1206_3216Metric_Pad1.30x1.75mm_HandSolder
R32, R33, R39, R40, R41, R42: 10; R_1206_3216Metric_Pad1.30x1.75mm_HandSolder
R35, R36, R37, R38: 22; R_1206_3216Metric_Pad1.30x1.75mm_HandSolder
R48, R49: 1k; R_1206_3216Metric_Pad1.30x1.75mm_HandSolder
SW1: SW_Push; SW_PUSH_6mm_H5mm
U1: MCP3208; DIP-16_W7.62mm
U2: LM4040DBZ-5.0; SOT-23_Handsoldering
U3: 24LC1025; DIP-8_W7.62mm
U4: Pico; RPi_Pico_SMD_TH
U5, U6: IR2110; DIP-14_W7.62mm

Connections:
+3V3: C10.1, J23.2, Q1.1 (G), Q2.1 (G), Q3.1 (G), Q4.1 (G), Q5.1 (G), Q6.1 (G), Q7.1 (G), Q8.1 (G), Q9.1 (G), Q10.1 (G), Q11.1 (G), Q12.1 (G), Q13.1 (G), Q15.1 (G), Q16.1 (G), R1.1, R2.1, R3.1, R4.1, R5.1, R10.1, R11.1, R12.1, R15.1, R16.1, R17.1, R20.1, R21.1, R22.1, R23.1, R24.1, R25.1, R26.1, R43.1, R44.1, R45.1, U3.8 (VCC), U4.36 (3V3)
+5V: C2.1, C8.1, D5.2 (A), J1.1, J10.1, J11.1, J12.1, J13.1, J14.1, J15.1, J21.1, J22.2, LS1.1, R6.1, R7.1, R8.1, R9.1, R18.1, R19.1, R46.1, R47.1, R48.1, R49.1, U1.16 (Vdd)
+15V: C7.1, C11.1, C12.1, C15.1, C16.1, J3.1, R14.1, R27.1, R28.1, R29.1, R30.1, R31.1, R32.2, R33.2, U5.3 (VCC), U5.9 (VDD), U6.3 (VCC), U6.9 (VDD)
/FULL_BRIDGE_SD: Q11.2 (S), R24.2, U4.29 (GPIO22)
/HALF_BRIDGE_0_HIN: Q9.2 (S), R22.2, U4.27 (GPIO21)
/HALF_BRIDGE_0_LIN: Q10.2 (S), R23.2, U4.24 (GPIO18)
/HALF_BRIDGE_1_HIN: Q12.2 (S), R25.2, U4.25 (GPIO19)
/HALF_BRIDGE_1_LIN: Q13.2 (S), R26.2, U4.26 (GPIO20)
/HV_MCP_CLK: Q1.3 (D), R6.2, U1.13 (CLK)
/HV_MCP_Din: Q3.3 (D), R8.2, U1.11 (Din)
/HV_MCP_Dout: Q2.3 (D), R7.2, U1.12 (Dout)
/HV_MCP_~CS: Q4.3 (D), R9.2, U1.10 (~CS/SHDN)
/I2C_LCD_SCL: J22.4, Q6.3 (D), R19.2
/I2C_LCD_SDA: J22.3, Q5.3 (D), R18.2
/I2C_PICO_SCL: Q6.2 (S), R16.2, U3.6 (SCL), U4.2 (GPIO1)
/I2C_PICO_SDA: Q5.2 (S), R15.2, U3.5 (SDA), U4.1 (GPIO0)
/IO_5V_0: Q7.2 (S), R20.2, U4.12 (GPIO9)
/IO_5V_1: Q8.2 (S), R21.2, U4.11 (GPIO8)
/IO_5V_2: Q15.2 (S), R44.2, U4.10 (GPIO7)
/IO_5V_3: Q16.2 (S), R45.2, U4.9 (GPIO6)
/PWM_SPEAKER: R34.2, U4.20 (GPIO15)
/SPI_PICO_CLK: Q1.2 (S), R1.2, U4.4 (GPIO2)
/SPI_PICO_RX: Q2.2 (S), R2.2, U4.6 (GPIO4)
/SPI_PICO_TX: Q3.2 (S), R3.2, U4.5 (GPIO3)
/SPI_PICO_~CS: Q4.2 (S), R4.2, U4.7 (GPIO5)
/SW0: C1.1, J16.1, R5.2, U4.14 (GPIO10)
/SW1: C3.1, J17.1, R10.2, U4.15 (GPIO11)
/SW2: C5.1, J18.1, R11.2, U4.16 (GPIO12)
/SW3: C6.1, J19.1, R12.2, U4.17 (GPIO13)
/SW4: C9.1, J20.1, R17.2, U4.19 (GPIO14)
/~RESET: C17.1, R43.2, SW1.1, U4.30 (RUN)
GND: C1.2, C2.2, C3.2, C4.2, C5.2, C6.2, C7.2, C8.2, C9.2, C10.2, C11.2, C12.2, C17.2, J1.2, J3.2, J8.3, J9.3, J10.2, J11.2, J12.2, J13.2, J14.2, J15.2, J16.2, J17.2, J18.2, J19.2, J20.2, J21.2, J22.1, J23.1, J23.5, Q14.3 (E), Q17.2 (E), Q18.2 (E), R13.2, SW1.2, U1.9 (DGND), U1.14 (AGND), U2.2 (A), U3.1 (A0), U3.2 (A1), U3.3 (A2), U3.4 (GND), U3.7 (WP), U4.3 (GND), U4.8 (GND), U4.13 (GND), U4.18 (GND), U4.23 (GND), U4.28 (GND), U4.33 (AGND), U4.38 (GND), U4.42 (GND), U5.2 (COM), U5.13 (VSS), U6.2 (COM), U6.13 (VSS)
unnamed: C4.1, R13.1, R14.2, U1.15 (Vref), U2.1 (K)
unnamed: C13.1, D3.1 (K), U5.6 (VB)
unnamed: C13.2, J8.2, U5.5 (VS)
unnamed: C14.1, D4.1 (K), U6.6 (VB)
unnamed: C14.2, J9.2, U6.5 (VS)
unnamed: C15.2, D7.1 (K), JP2.1 (A), R36.1, U5.1 (LO)
unnamed: C16.2, D9.1 (K), JP4.1 (A), R38.1, U6.1 (LO)
unnamed: D3.2 (A), R32.1
unnamed: D4.2 (A), R33.1
unnamed: D5.1 (K), U4.39 (VSYS)
unnamed: D6.1 (K), JP1.1 (A), R35.1, U5.7 (HO)
unnamed: D6.2 (A), R35.2, R39.1
unnamed: D7.2 (A), R36.2, R40.1
unnamed: D8.1 (K), JP3.1 (A), R37.1, U6.7 (HO)
unnamed: D8.2 (A), R37.2, R41.1
unnamed: D9.2 (A), R38.2, R42.1
unnamed: J8.1, JP1.2 (B), R39.2
unnamed: J8.4, JP2.2 (B), R40.2
unnamed: J9.1, JP3.2 (B), R41.2
unnamed: J9.4, JP4.2 (B), R42.2
unnamed: J10.3, U1.1 (CH0)
unnamed: J11.3, U1.2 (CH1)
unnamed: J12.3, U1.3 (CH2)
unnamed: J13.3, U1.4 (CH3)
unnamed: J14.3, U1.5 (CH4)
unnamed: J15.3, U1.6 (CH5)
unnamed: J21.3, Q7.3 (D), R46.2
unnamed: J21.4, Q8.3 (D), R47.2
unnamed: J21.5, Q17.3 (C)
unnamed: J21.6, Q18.3 (C)
unnamed: J23.3, U4.35 (ADC_VREF)
unnamed: J23.4, U4.34 (GPIO28_ADC2)
unnamed: J23.6, U4.32 (GPIO27_ADC1)
unnamed: J23.7, U4.31 (GPIO26_ADC0)
unnamed: LS1.2, Q14.2 (C)
unnamed: Q9.3 (D), R27.2, U5.10 (HIN)
unnamed: Q10.3 (D), R28.2, U5.12 (LIN)
unnamed: Q11.3 (D), R29.2, U5.11 (SD), U6.11 (SD)
unnamed: Q12.3 (D), R30.2, U6.10 (HIN)
unnamed: Q13.3 (D), R31.2, U6.12 (LIN)
unnamed: Q14.1 (B), R34.1
unnamed: Q15.3 (D), Q17.1 (B), R48.2
unnamed: Q16.3 (D), Q18.1 (B), R49.2

Notes on the sheet:
Mount free wheel diode on Speaker

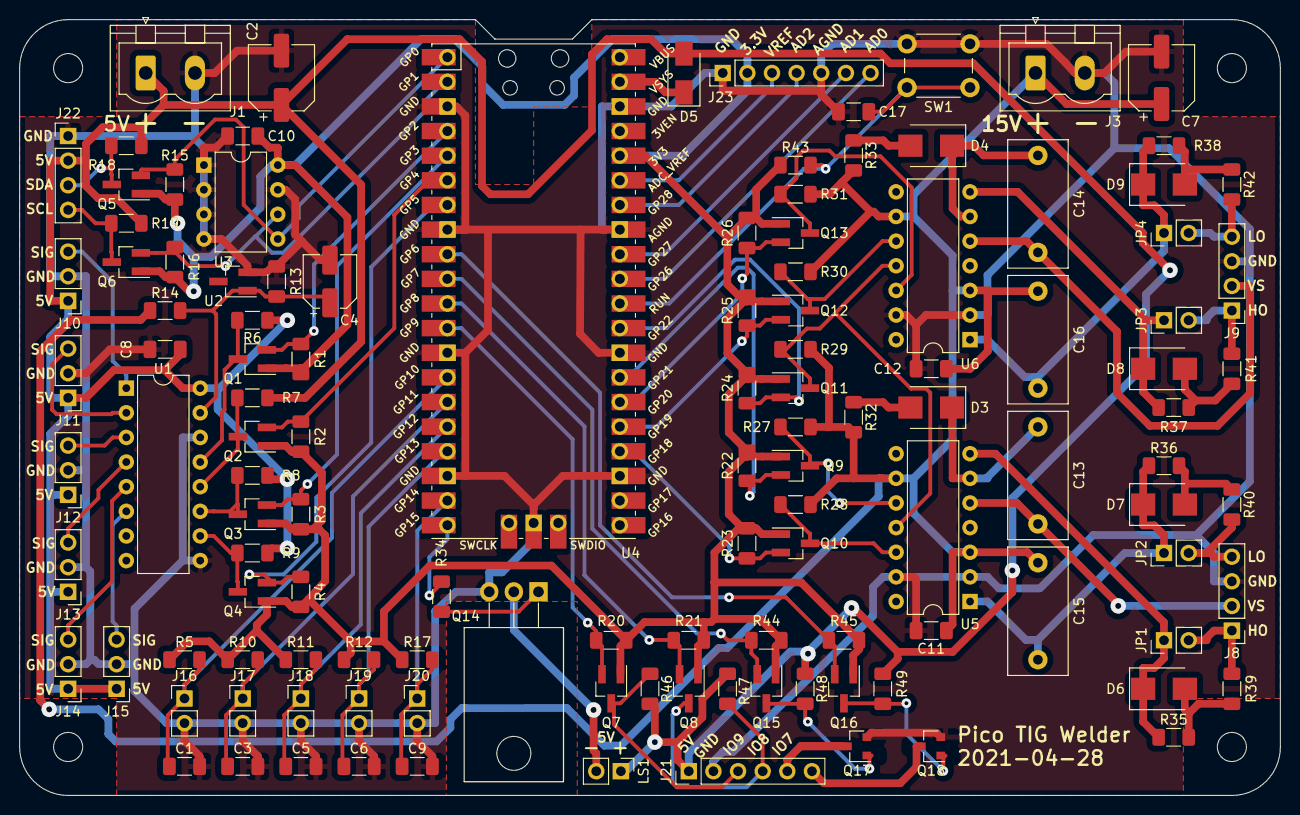
[picture p15: board pico-controller.kicad_pcb from above]

Board: 2 copper layers, 130.0 x 80.0 mm, 125 parts (0 on the bottom side), 75 nets.
