cclienti/tig-welder/firmware/pico/src/lcd_menu.cpp

// This file is part of the tig-welder project
// (https://github.com/cclienti/tig-welder)
// Copyright (c) 2021 Christophe Clienti
//
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
#include "tig-welder/lcd_menu_entry.h"
#include "tig-welder/lcd_menu_footer.h"
#include "tig-welder/lcd_menu.h"
#include "tig-welder/lcd_display.h"
#include "tig-welder/rotary_encoder.h"
#include "tig-welder/switch.h"
#include "tig-welder/buzzer.h"


LCDMenu::LCDMenu(LCDDisplayUPtr lcd_display, RotaryEncoderUPtr rotary_encoder,
                 SwitchUPtr button, BuzzerSPtr buzzer):
	m_lcd_display      (std::move(lcd_display)),
	m_rotary_encoder   (std::move(rotary_encoder)),
	m_button           (std::move(button)),
	m_buzzer           (buzzer),
	m_menu_entry_id    (0),
	m_change_value     (false),
	m_footer_separator (static_cast<std::size_t>(m_lcd_display->get_num_cols()), '\x04')
{
	m_rotary_encoder->set_rotation(0);
	m_lcd_display->clear();
	m_lcd_display->home();

	// Write custom chars for splash
	std::uint8_t char_1[8] = {0x07, 0x04, 0x04, 0x1C, 0x1C, 0x04, 0x04, 0x07}; // splash -[
	std::uint8_t char_2[8] = {0x1C, 0x04, 0x04, 0x07, 0x07, 0x04, 0x04, 0x1C}; // splash ]-
	std::uint8_t char_3[8] = {0x00, 0x00, 0x00, 0x1F, 0x1F, 0x00, 0x00, 0x00}; // Thick dot
	std::uint8_t char_4[8] = {0x00, 0x00, 0x00, 0x00, 0x00, 0x1F, 0x1F, 0x00}; // Thick underscore
	std::uint8_t char_5[8] = {0x03, 0x06, 0x0C, 0x18, 0x18, 0x0C, 0x06, 0x03}; // Title <
	std::uint8_t char_6[8] = {0x18, 0x0C, 0x06, 0x03, 0x03, 0x06, 0x0C, 0x18}; // Title >
	m_lcd_display->set_char(1, char_1);
	m_lcd_display->set_char(2, char_2);
	m_lcd_display->set_char(3, char_3);
	m_lcd_display->set_char(4, char_4);
	m_lcd_display->set_char(5, char_5);
	m_lcd_display->set_char(6, char_6);
}


void LCDMenu::register_menu(const std::string &title, bool &variable)
{
	const auto &menu = std::make_shared<MenuEntryBool>(m_lcd_display->get_num_cols(), title,
	                                                   '\x03', '\x05', '\x06',
	                                                   variable);
	m_menu_entries.insert(m_menu_entries.begin(), menu);
}


void LCDMenu::register_menu(const std::string &title, int &variable,
                             int min, int max, const std::string &unit)
{
	const auto &menu = std::make_shared<MenuEntryInt>(m_lcd_display->get_num_cols(), title,
	                                                   '\x03', '\x05', '\x06',
	                                                  variable,
	                                                  min, max, unit);
	m_menu_entries.insert(m_menu_entries.begin(), menu);
}


void LCDMenu::register_menu(const std::string &title, float &variable,
                             float min, float max, float precision,
                             const std::string &unit)
{
	const auto &menu = std::make_shared<MenuEntryFloat>(m_lcd_display->get_num_cols(), title,
	                                                   '\x03', '\x05', '\x06',
	                                                    variable,
	                                                    min, max, precision, unit);
	m_menu_entries.insert(m_menu_entries.begin(), menu);
}


void LCDMenu::register_footer(FooterPosition position,
                              const std::string &text, const bool &variable)
{
	const auto &note = std::make_shared<FooterNoteBool>(m_lcd_display->get_num_cols()/2-1,
	                                                    text, variable);
	if (position == FooterPosition::Left) {
		m_footer_left = note;
	}
	else {
		m_footer_right = note;
	}
}


void LCDMenu::register_footer(FooterPosition position,
                              const std::string &text, const int &variable,
                              const std::string &unit)
{
	const auto &note = std::make_shared<FooterNoteInt>(m_lcd_display->get_num_cols()/2-1,
	                                                    text, variable, unit);
	if (position == FooterPosition::Left) {
		m_footer_left = note;
	}
	else {
		m_footer_right = note;
	}
}


void LCDMenu::register_footer(FooterPosition position,
                              const std::string &text,
                              const float &variable, float precision,
                              const std::string &unit)
{
	const auto &note = std::make_shared<FooterNoteFloat>(m_lcd_display->get_num_cols()/2-1,
	                                                     text, variable, precision, unit);
	if (position == FooterPosition::Left) {
		m_footer_left = note;
	}
	else {
		m_footer_right = note;
	}
}


void LCDMenu::refresh()
{
	if (is_splashed) {
		m_lcd_display->clear();
		is_splashed = false;
	}

	is_refreshed = true;

	refresh_menu();
	refresh_footer();
}


void LCDMenu::splash(const std::string &text)
{
	if (is_refreshed) {
		m_lcd_display->clear();
		is_refreshed = false;
	}

	is_splashed = true;

	m_lcd_display->set_pos(0, 0);
	m_lcd_display->print(MenuEntryBase::format_info("\x01" + text + "\x02",
	                                                m_lcd_display->get_num_cols(), '\x03'));
	refresh_footer();
}


void LCDMenu::refresh_menu()
{
	if (m_menu_entries.empty()) {
		return;
	}

	const auto &entry = m_menu_entries[m_menu_entry_id];

	bool button_released = m_button->is_released();
	m_change_value = m_change_value ^ button_released;

	if (m_change_value) {
		if (button_released) {
			m_rotary_encoder->set_rotation(entry->get_encoder_from_value());
		}
	}
	else {
		if (button_released) {
			m_rotary_encoder->set_rotation(m_menu_entry_id);
		}
		m_menu_entry_id = m_rotary_encoder->get_rotation() % m_menu_entries.size();
	}

	m_lcd_display->set_pos(m_title_line, 0);
	m_lcd_display->print(entry->get_formatted_title());

	if (m_change_value) {
		auto rotation = m_rotary_encoder->get_rotation();
		entry->set_value_from_encoder(rotation);
		auto rotation_update = entry->get_encoder_from_value();
		if (rotation != rotation_update) {
			// The value can be clipped by the entry class, we update the
			// rotary encoder back.
			m_rotary_encoder->set_rotation(rotation_update);
		}
	}

	m_lcd_display->set_pos(m_value_line, 0);
	m_lcd_display->print(entry->get_formatted_value());
}


void LCDMenu::refresh_footer()
{
	m_lcd_display->set_pos(m_separator_line, 0);
	m_lcd_display->print(m_footer_separator);

	if (m_footer_left) {
		m_lcd_display->set_pos(m_footer_line, 0);
		m_lcd_display->print(m_footer_left->get_display());
	}

	m_lcd_display->set_pos(m_footer_line, m_lcd_display->get_num_cols()/2);
	m_lcd_display->putchar(' ');

	if (m_footer_right) {
		m_lcd_display->set_pos(m_footer_line, m_lcd_display->get_num_cols()/2+1);
		m_lcd_display->print(m_footer_right->get_display());
	}
}
