cclienti/tig-welder/firmware/dspic30f4012/src/ascii_fonts.c

#include "ascii_fonts.h"

uint8_t misc_fixed_5x7[][5] = {
    {0x00, 0x00, 0x00, 0x00, 0x00}, // USER  
    {0x00, 0x00, 0x00, 0x00, 0x00}, // USER  
    {0x00, 0x00, 0x00, 0x00, 0x00}, // USER  
    {0x00, 0x00, 0x00, 0x00, 0x00}, // USER  
    {0x00, 0x00, 0x00, 0x00, 0x00}, // USER  
    {0x00, 0x00, 0x00, 0x00, 0x00}, // USER  
    {0x00, 0x00, 0x00, 0x00, 0x00}, // USER  
    {0x00, 0x00, 0x00, 0x00, 0x00}, // USER
    {0x00, 0x00, 0x00, 0x00, 0x00}, // 32 -  
    {0x00, 0x00, 0x7a, 0x00, 0x00}, // 33 - !
    {0x00, 0x70, 0x00, 0x70, 0x00}, // 34 - "
    {0x14, 0x3e, 0x14, 0x3e, 0x14}, // 35 - #
    {0x04, 0x2a, 0x3e, 0x2a, 0x10}, // 36 - $
    {0x00, 0x26, 0x10, 0x08, 0x64}, // 37 - %
    {0x00, 0x02, 0x14, 0x2a, 0x14}, // 38 - &
    {0x00, 0x00, 0x70, 0x00, 0x00}, // 39 - '
    {0x00, 0x00, 0x42, 0x3c, 0x00}, // 40 - (
    {0x00, 0x00, 0x3c, 0x42, 0x00}, // 41 - )
    {0x00, 0x2a, 0x1c, 0x2a, 0x00}, // 42 - *
    {0x08, 0x08, 0x3e, 0x08, 0x08}, // 43 - +
    {0x00, 0x04, 0x06, 0x01, 0x00}, // 44 - ,
    {0x00, 0x08, 0x08, 0x08, 0x08}, // 45 - -
    {0x00, 0x00, 0x06, 0x06, 0x00}, // 46 - .
    {0x00, 0x20, 0x10, 0x08, 0x04}, // 47 - /
    {0x00, 0x3c, 0x42, 0x3c, 0x00}, // 48 - 0
    {0x00, 0x02, 0x7e, 0x22, 0x00}, // 49 - 1
    {0x00, 0x32, 0x4a, 0x46, 0x22}, // 50 - 2
    {0x00, 0x6c, 0x52, 0x52, 0x44}, // 51 - 3
    {0x00, 0x08, 0x7e, 0x28, 0x18}, // 52 - 4
    {0x00, 0x4c, 0x52, 0x52, 0x74}, // 53 - 5
    {0x00, 0x0c, 0x52, 0x52, 0x3c}, // 54 - 6
    {0x00, 0x60, 0x58, 0x46, 0x40}, // 55 - 7
    {0x00, 0x2c, 0x52, 0x52, 0x2c}, // 56 - 8
    {0x00, 0x3c, 0x4a, 0x4a, 0x30}, // 57 - 9
    {0x00, 0x00, 0x36, 0x36, 0x00}, // 58 - :
    {0x00, 0x00, 0x34, 0x36, 0x01}, // 59 - ;
    {0x00, 0x22, 0x14, 0x08, 0x00}, // 60 - <
    {0x00, 0x14, 0x14, 0x14, 0x14}, // 61 - =
    {0x00, 0x08, 0x14, 0x22, 0x00}, // 62 - >
    {0x00, 0x30, 0x4a, 0x20, 0x00}, // 63 - ?
    {0x00, 0x38, 0x5a, 0x42, 0x3c}, // 64 - @
    {0x00, 0x3e, 0x48, 0x48, 0x3e}, // 65 - A
    {0x00, 0x2c, 0x52, 0x52, 0x7e}, // 66 - B
    {0x00, 0x24, 0x42, 0x42, 0x3c}, // 67 - C
    {0x00, 0x3c, 0x42, 0x42, 0x7e}, // 68 - D
    {0x00, 0x42, 0x52, 0x52, 0x7e}, // 69 - E
    {0x00, 0x40, 0x50, 0x50, 0x7e}, // 70 - F
    {0x00, 0x2e, 0x4a, 0x42, 0x3c}, // 71 - G
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
    {0x00, 0x04, 0x08, 0x10, 0x20}, // 92 - backslash
    {0x00, 0x7e, 0x42, 0x42, 0x00}, // 93 - ]
    {0x00, 0x20, 0x40, 0x20, 0x00}, // 94 - ^
    {0x00, 0x02, 0x02, 0x02, 0x02}, // 95 - _
    {0x00, 0x00, 0x20, 0x40, 0x00}, // 96 - `
    {0x00, 0x1e, 0x14, 0x12, 0x0c}, // 97 - a
    {0x00, 0x0c, 0x12, 0x12, 0x7e}, // 98 - b
    {0x00, 0x00, 0x12, 0x12, 0x0c}, // 99 - c
    {0x00, 0x7e, 0x12, 0x12, 0x0c}, // 100 - d
    {0x00, 0x08, 0x1a, 0x16, 0x0c}, // 101 - e
    {0x00, 0x20, 0x48, 0x3e, 0x08}, // 102 - f
    {0x00, 0x19, 0x15, 0x15, 0x0a}, // 103 - g
    {0x00, 0x0e, 0x10, 0x10, 0x7e}, // 104 - h
    {0x00, 0x02, 0x5e, 0x12, 0x00}, // 105 - i
    {0x00, 0x5e, 0x01, 0x02, 0x00}, // 106 - j
    {0x00, 0x02, 0x14, 0x08, 0x7e}, // 107 - k
    {0x00, 0x02, 0x7e, 0x42, 0x00}, // 108 - l
    {0x00, 0x0e, 0x18, 0x08, 0x1e}, // 109 - m
    {0x00, 0x0e, 0x10, 0x10, 0x1e}, // 110 - n
    {0x00, 0x0c, 0x12, 0x12, 0x0c}, // 111 - o
    {0x00, 0x0c, 0x12, 0x12, 0x1f}, // 112 - p
    {0x00, 0x1f, 0x12, 0x12, 0x0c}, // 113 - q
    {0x00, 0x08, 0x10, 0x10, 0x1e}, // 114 - r
    {0x00, 0x14, 0x16, 0x1a, 0x0a}, // 115 - s
    {0x00, 0x02, 0x12, 0x7c, 0x10}, // 116 - t
    {0x00, 0x1e, 0x02, 0x02, 0x1c}, // 117 - u
    {0x00, 0x1c, 0x02, 0x1c, 0x00}, // 118 - v
    {0x00, 0x1e, 0x06, 0x06, 0x1e}, // 119 - w
    {0x00, 0x12, 0x0c, 0x0c, 0x12}, // 120 - x
    {0x00, 0x1c, 0x02, 0x05, 0x18}, // 121 - y
    {0x00, 0x12, 0x1a, 0x16, 0x12}, // 122 - z
    {0x00, 0x42, 0x3c, 0x10, 0x00}, // 123 - {
    {0x00, 0x00, 0x7e, 0x00, 0x00}, // 124 - |
    {0x00, 0x10, 0x3c, 0x42, 0x00}, // 125 - }
    {0x00, 0x40, 0x20, 0x40, 0x20}, // 126 - ~
};
