cclienti/tig-welder/(commit log)

2021-05-13 Initial commit of schedmatic and pcb files
    [half-bridge.kicad_pcb, half-bridge.sch, pico-controller.kicad_pcb, pico-controller.sch, small-power.kicad_pcb, small-power.sch]
2021-05-13 Moving to git submodules for the pico-sdk
2021-05-13 Fixed CMakeLists.txt to use the pico SDK as a submodule
2021-05-13 Switched LCDDisplay to a basic but efficient printf method
2021-05-13 Added Switch and Relay class
2021-05-13 Added the Rotary Encoder (PIO) and the ADC (MCP3208) classes
2021-05-13 Reworked the half-bridge to be more modular
    [half-bridge-mod.kicad_pcb, half-bridge-mod.sch, half-bridge.kicad_pcb, half-bridge.sch]
2021-05-13 Reduced volatage of the speaker in the tig-welder controller board
    [pico-controller.kicad_pcb, pico-controller.sch]
2021-05-13 Added a notebook to generate the LUT for the thermistance CTN
    The CTN is used by the tig-welder controller board to monitor the
    H-Bridge temperature during welding.
    [ctn.csv, ctn_interpolated.csv]
2021-05-13 Updated git ignore to hide some kicad files
2021-05-13 Added support for the buzzer in the firmware of the controller
    [buzzer.cpp, main.cpp]
2021-05-13 Moved schematics and PCB to a dedicated root dir
    [ctn.csv, ctn_interpolated.csv, half-bridge-mod.kicad_pcb, half-bridge-mod.sch, pico-controller.kicad_pcb, pico-controller.sch, small-power.kicad_pcb, small-power.sch]
2021-05-13 Added a script to build the picoprobe and the openocd of the pi pico
2021-05-13 Changed branch of the pico-sdk to tag 1.1.2
2021-05-13 Fixed bad parameter order in LCDDisplay ctor
    The num_lines and num_cols were interchanged. Default values for cols
    where apply to lines and vice versa.
    [lcd_display.cpp]
2021-05-13 Fixed high power consumption when the buzzer is idle
    [buzzer.cpp]
2021-05-14 Added mute/unmute capability to the buzzer class
    [buzzer.cpp]
2021-05-14 Fixed float precision display in the LCDMenu class
    [lcd_menu.cpp]
2021-05-14 Manage menu default value at the registration step
    The variable tracked by the menu can be not correctly initialized. By
    using the get/set_value from the menu entry class, we ensure that the
    value tracked is legal.
    [lcd_menu.cpp]
2021-05-14 Reworked the main process to enable buzzer mute/unmute
    [main.cpp]
2021-05-14 Fixed issues with the MenuEntryInt (bad unit and bad cast)
    [lcd_menu.cpp]
2021-05-14 Added a struct to hold all welding parameters
2021-05-15 Reworked menu entry class to simplify the refresh function
    [lcd_menu.cpp, main.cpp]
2021-05-15 Reworked splash screen display in the LCDMenu class
    [lcd_menu.cpp]
2021-05-24 Added a script to flash the pico without a debugger
2021-05-24 Added docs in the notebook to describe the CTN connection
    [ctn_interpolated.csv]
2021-05-24 First version of a welding basic control loop
2021-06-03 Added functions to average successive ADC reads
2021-06-03 Reworked the warning sound in the buzzer class
    [buzzer.cpp]
2021-06-03 Improved the script to flash the PICO using the serial interface
2021-06-03 Moved the pico firmware in a dedicated firmware project
2021-06-03 Added the pic18f2550 firmware for the simple relay welder project
2021-06-04 Added print methods to display string, int and decimal numbers
2021-06-06 Added mechanical schematics
    [front.scad]
2021-06-13 Added an opto-isolated mosfet/igbt driver board
    [dspic-controller.kicad_pcb, dspic-controller.sch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]
2021-06-13 Exchanged the ARC pin with the GAZ pin
2021-06-21 Added the dsPIC30F4012 controller board
    [dspic-controller.kicad_pcb, dspic-controller.sch, front.scad, power-driver.sch]
2021-07-15 Added the relay board to manage GAZ and HF Spark start
    [slow-switching-outputs.kicad_pcb, slow-switching-outputs.sch]
2023-11-25 pico-controller: added the cache lib
2023-11-25 pico-controller: switched to kicad 7
    [pico-controller.kicad_pcb, pico-controller.kicad_sch, pico-controller.sch]
2023-11-25 dspic-controller: updated the project to kicad 7
    [dspic-controller.kicad_pcb, dspic-controller.kicad_sch, dspic-controller.sch]
2023-11-25 half-bridge-mod: updated to kicad 7
    [half-bridge-mod.kicad_pcb, half-bridge-mod.kicad_sch, half-bridge-mod.sch]
2023-11-25 power-driver: updated to kicad 7
    [power-driver.kicad_pcb, power-driver.kicad_sch, power-driver.sch]
2023-11-25 slow-switching-outputs: updated to kicad 7
    [slow-switching-outputs.kicad_pcb, slow-switching-outputs.kicad_sch, slow-switching-outputs.sch]
2023-11-25 small-power: updated to kicad 7
    [small-power.kicad_pcb, small-power.kicad_sch, small-power.sch]
